SteveT10/MX104-HS/media/repo/3dRenderBack.png

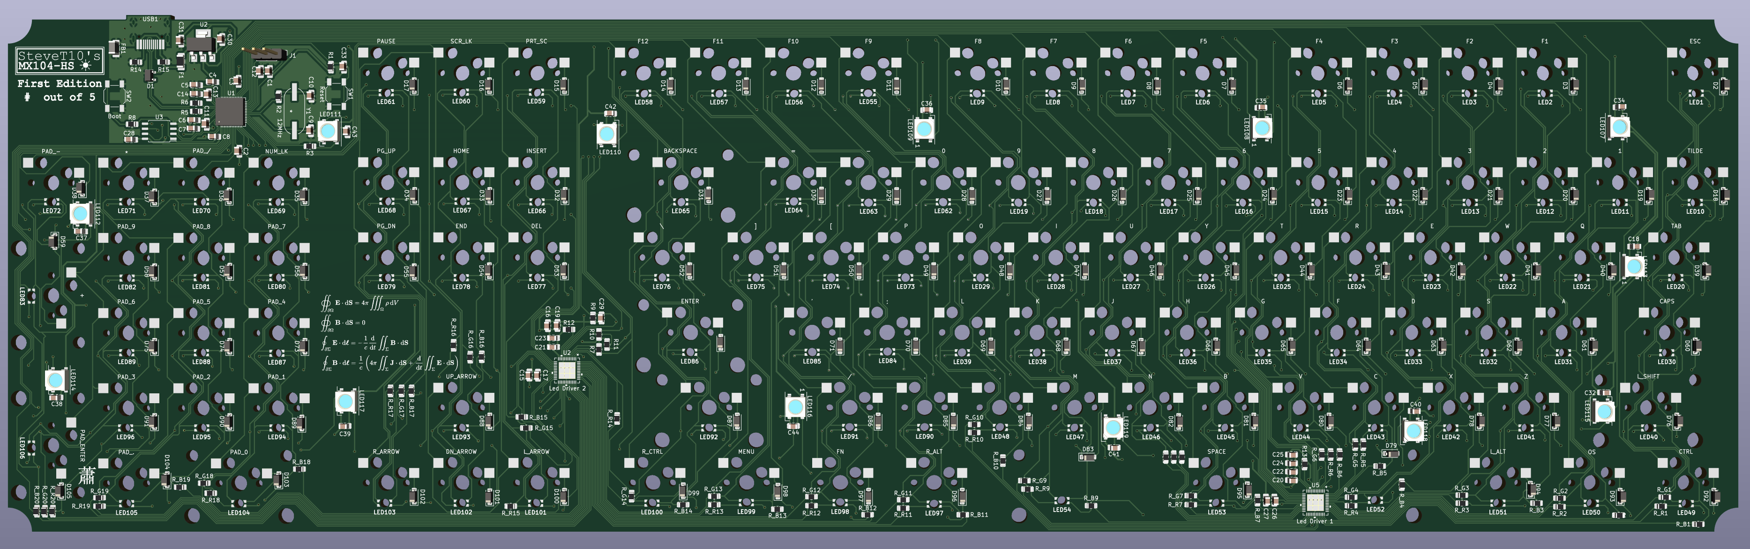
media/repo/3dRenderBack.png
