SteveT10/MX104-HS/media/repo/3dRenderFront.png

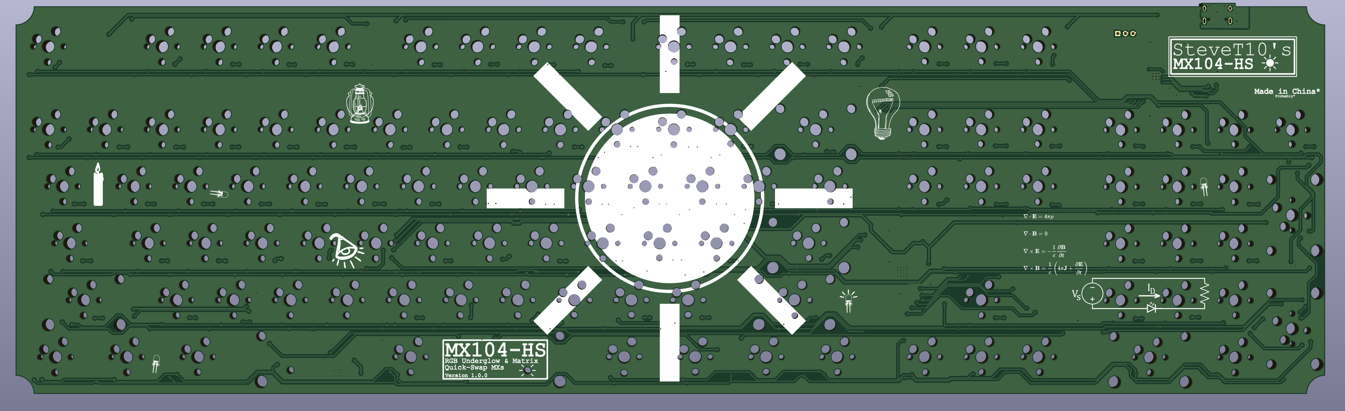
media/repo/3dRenderFront.png
