SteveT10/MX104-HS/media/repo/front_layout.png

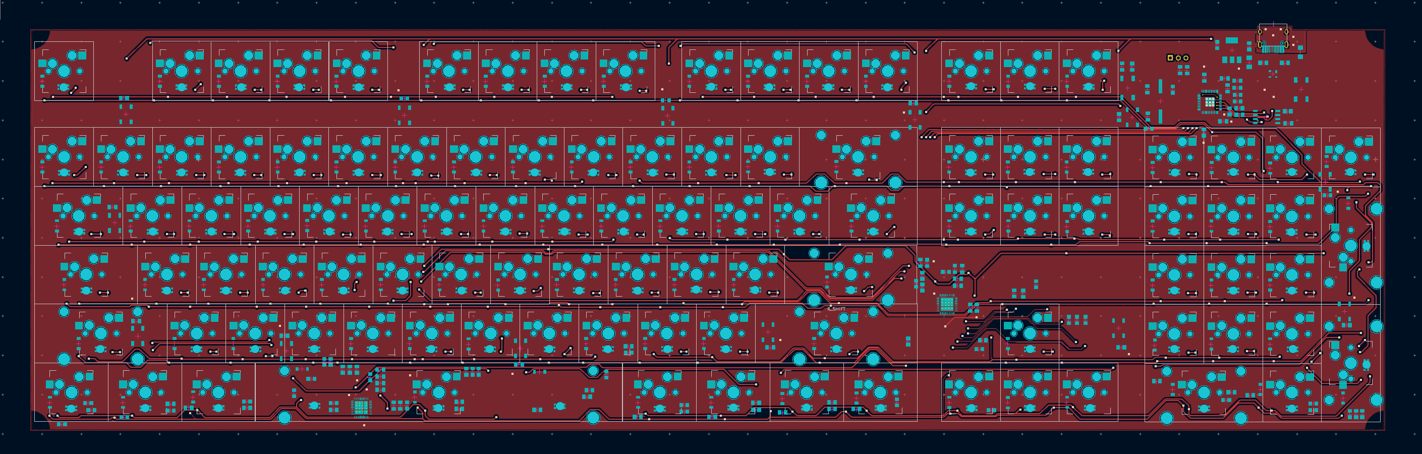
media/repo/front_layout.png
