SteveT10/MX104-HS/media/repo/front_PCB3.jpg

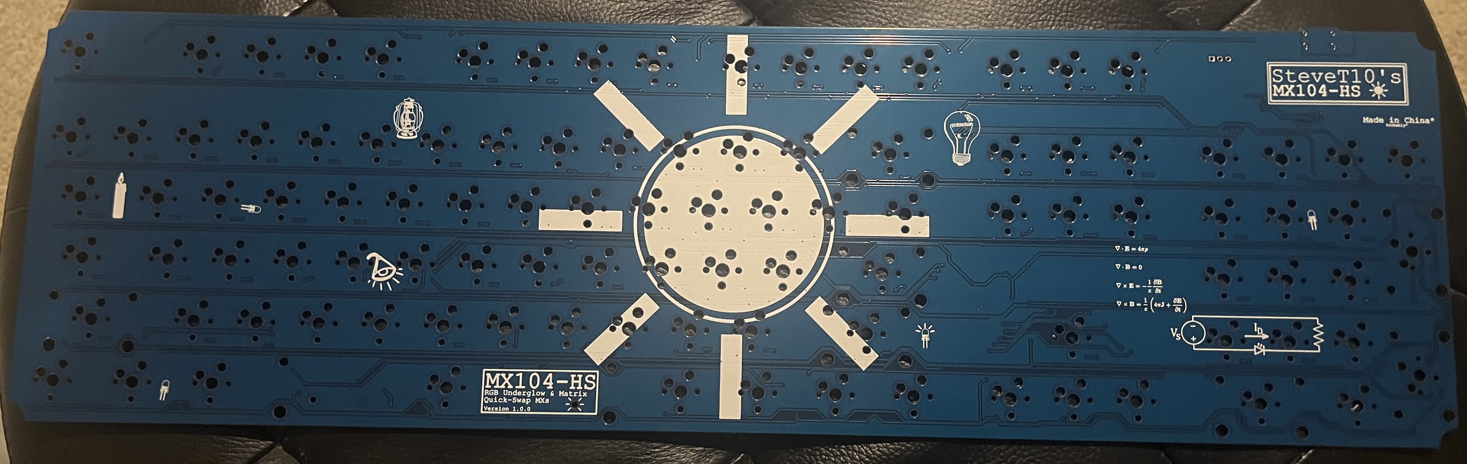
media/repo/front_PCB3.jpg
