SteveT10/MX104-HS/media/repo/full_layout.png

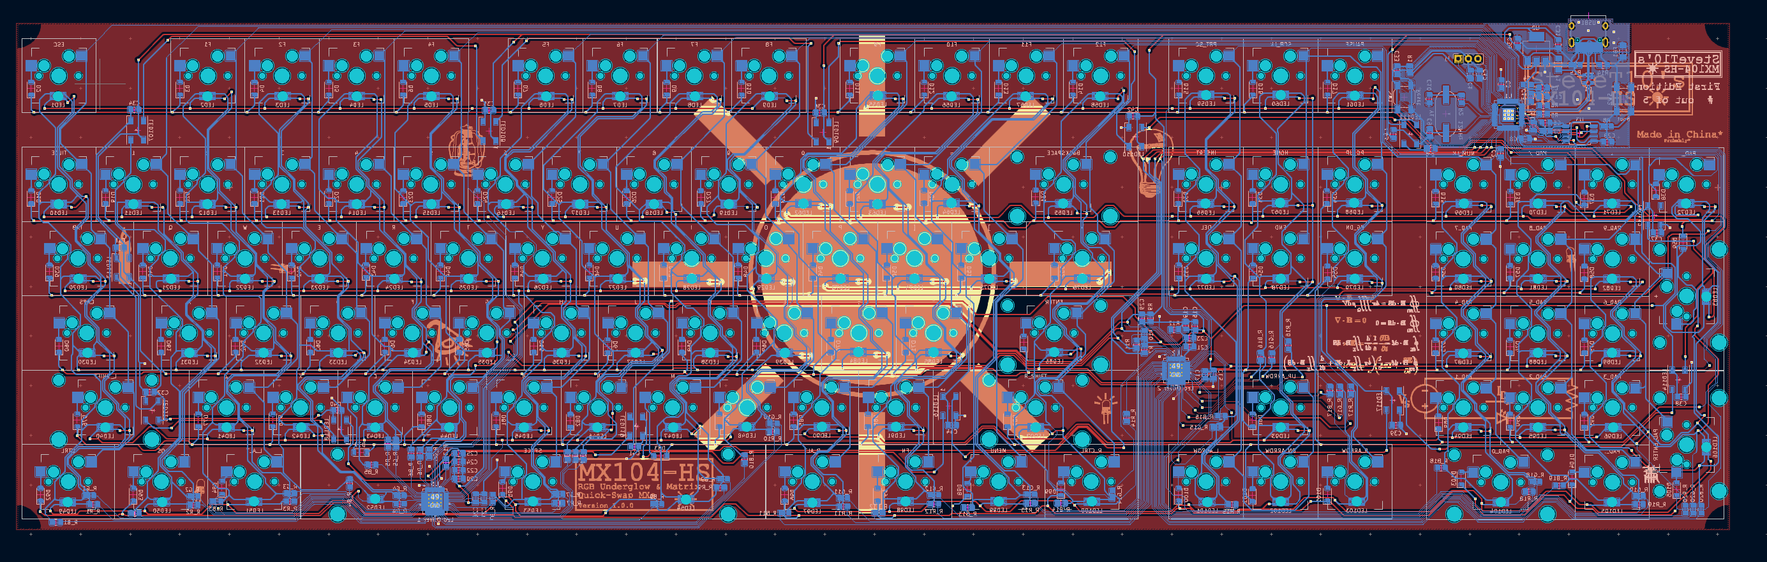
media/repo/full_layout.png
