SteveT10/MX104-HS/media/repo/KeyMatrices.png

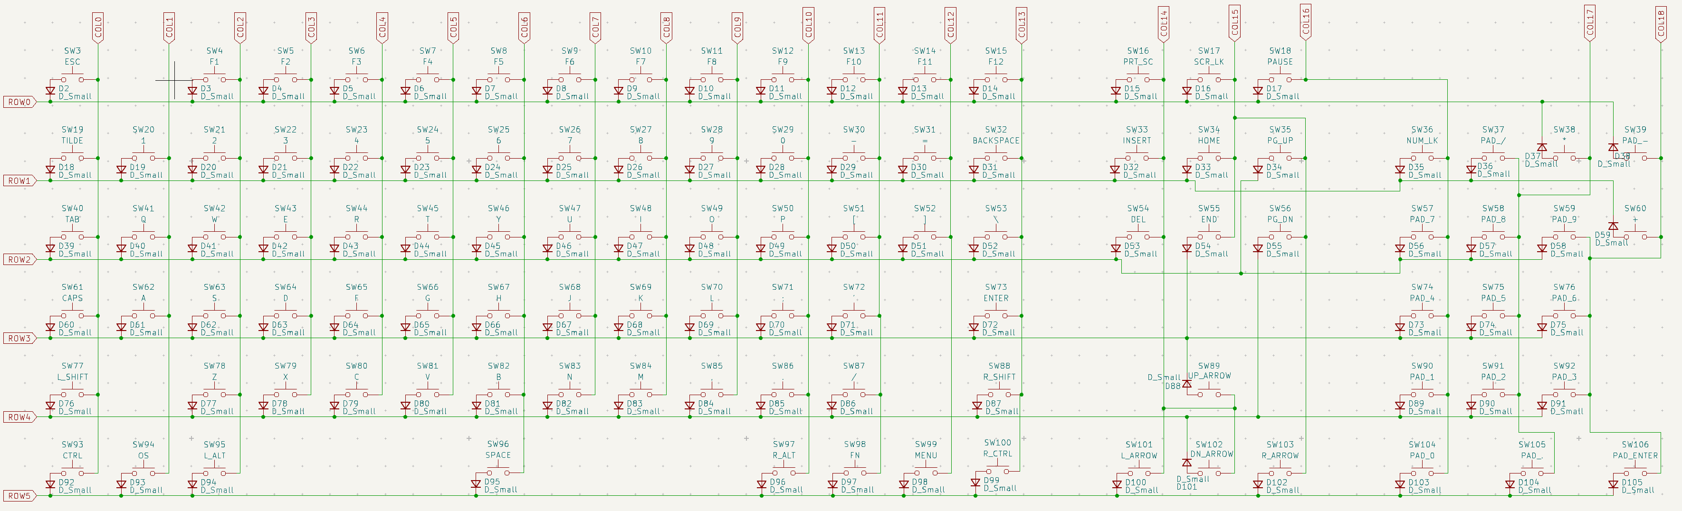
media/repo/KeyMatrices.png
