SteveT10/MX104-HS/media/repo/LedDriver1_layout.png

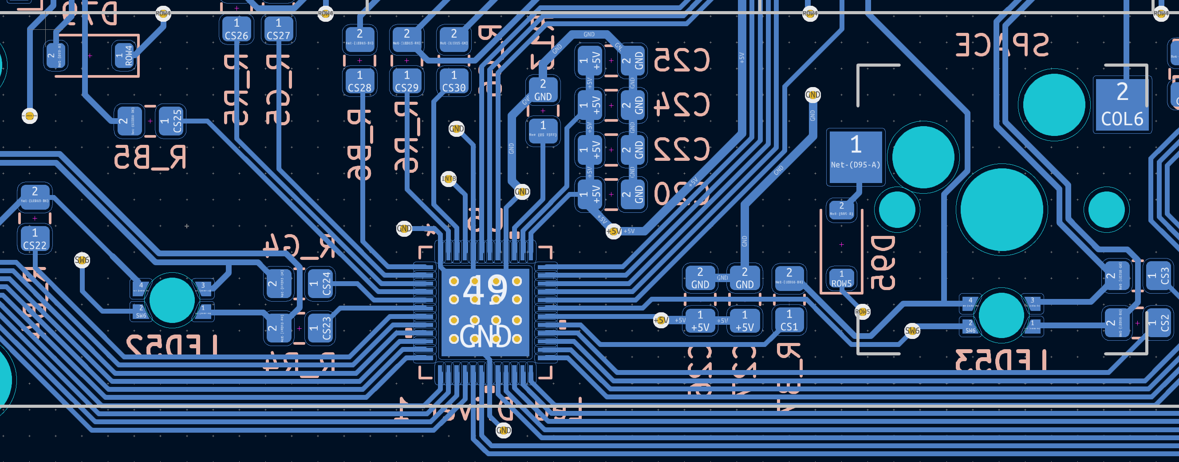
media/repo/LedDriver1_layout.png
