SteveT10/MX104-HS/media/repo/LedDriver2_layout.png

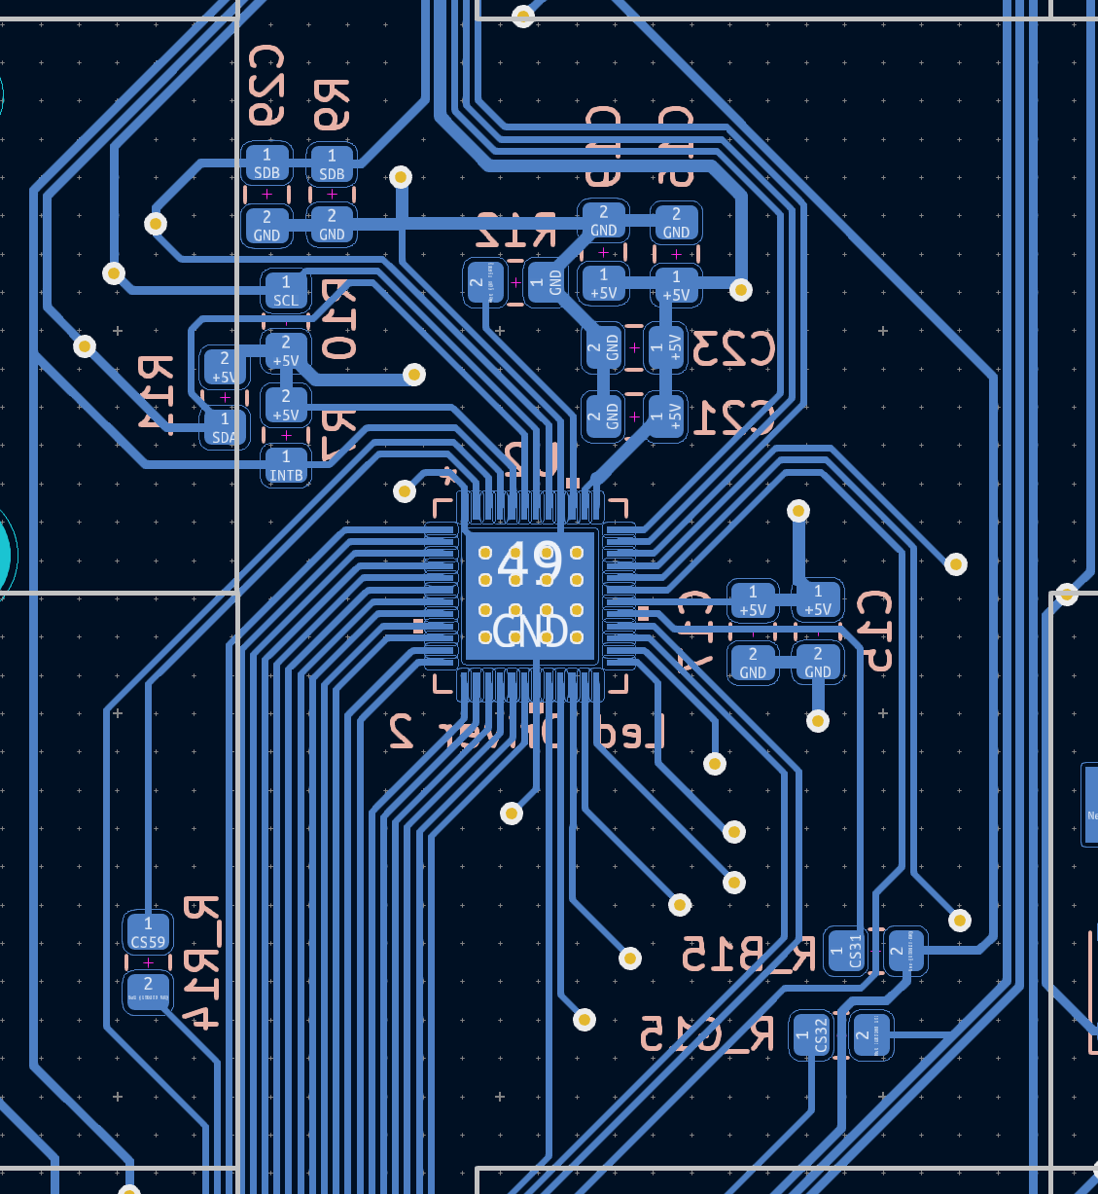
media/repo/LedDriver2_layout.png
