SteveT10/MX104-HS/media/repo/LEDS_sch.png

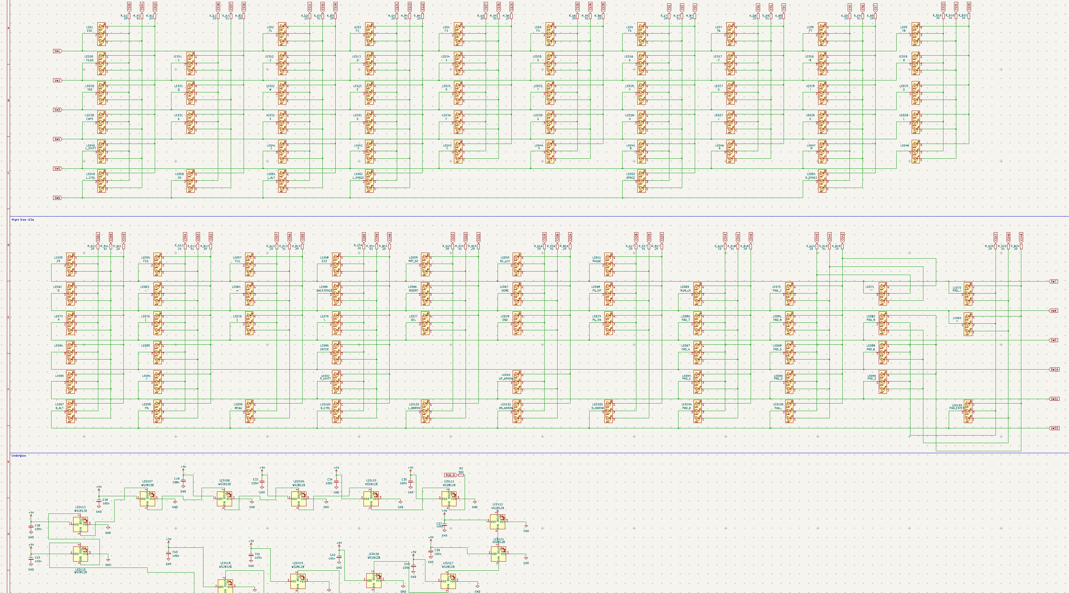
media/repo/LEDS_sch.png
