SteveT10/MX104-HS/media/repo/Main_sch.png

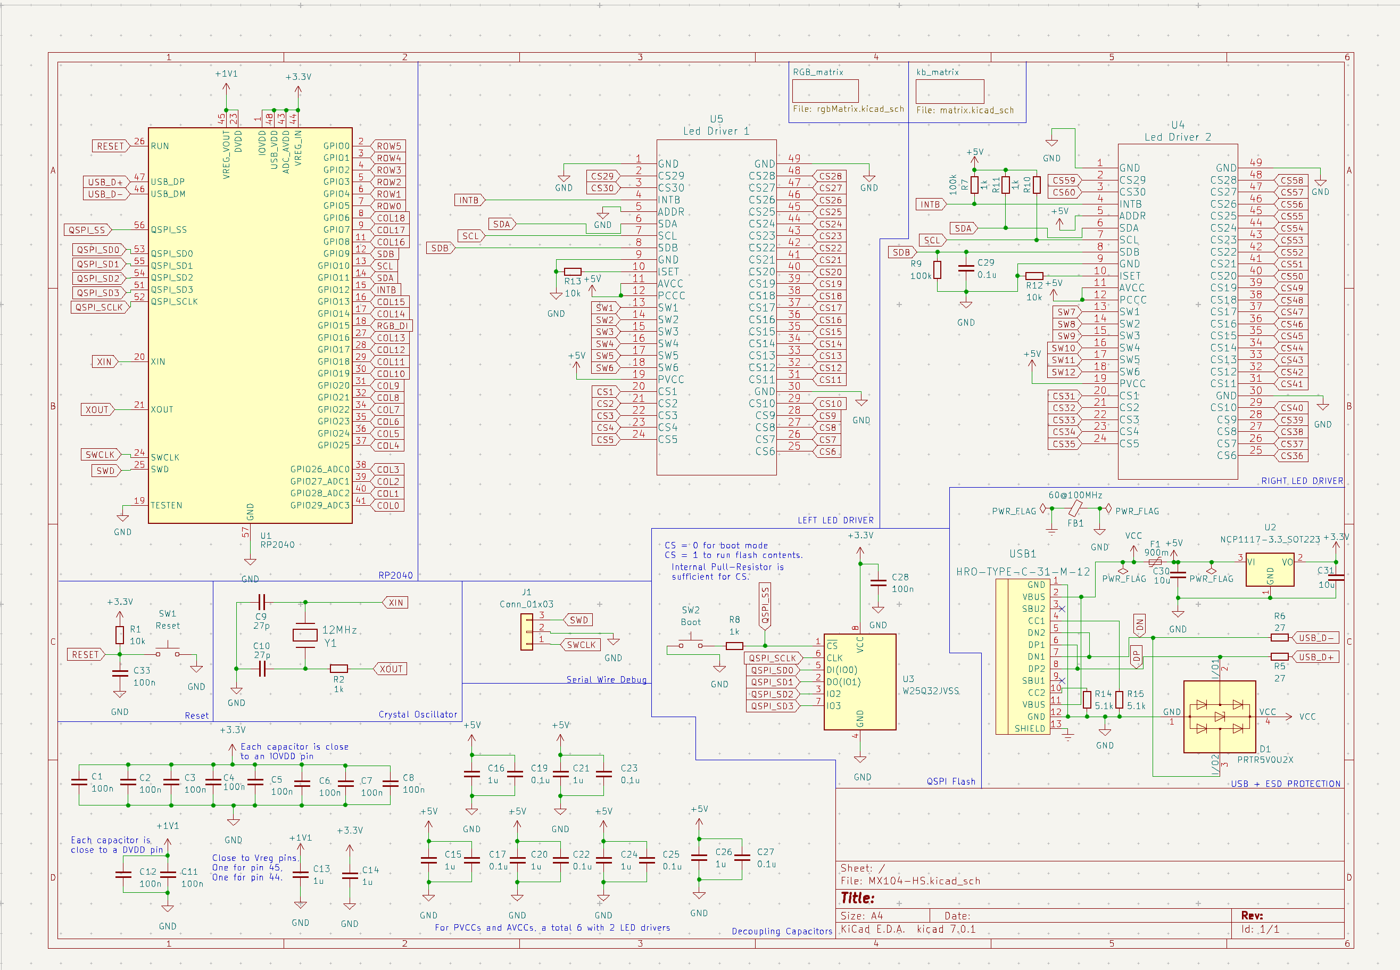
media/repo/Main_sch.png
