SteveT10/MX104-HS/media/repo/RP2040_layout.png

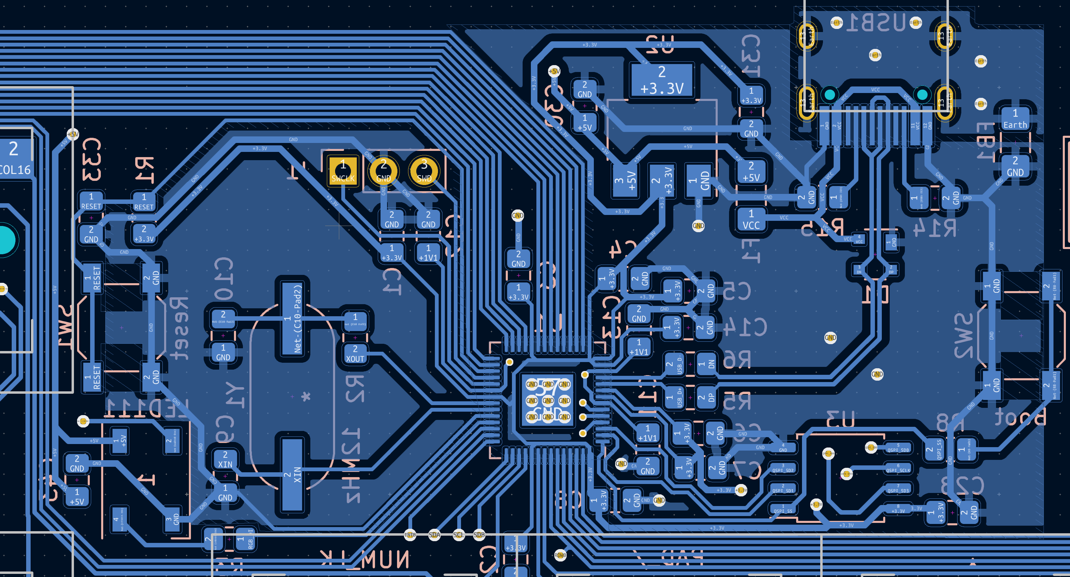
media/repo/RP2040_layout.png
