SteveT10/MX104-HS/MX104-HS.kicad_sch

## KiCad design MX104-HS.kicad_sch (2023-07-06)

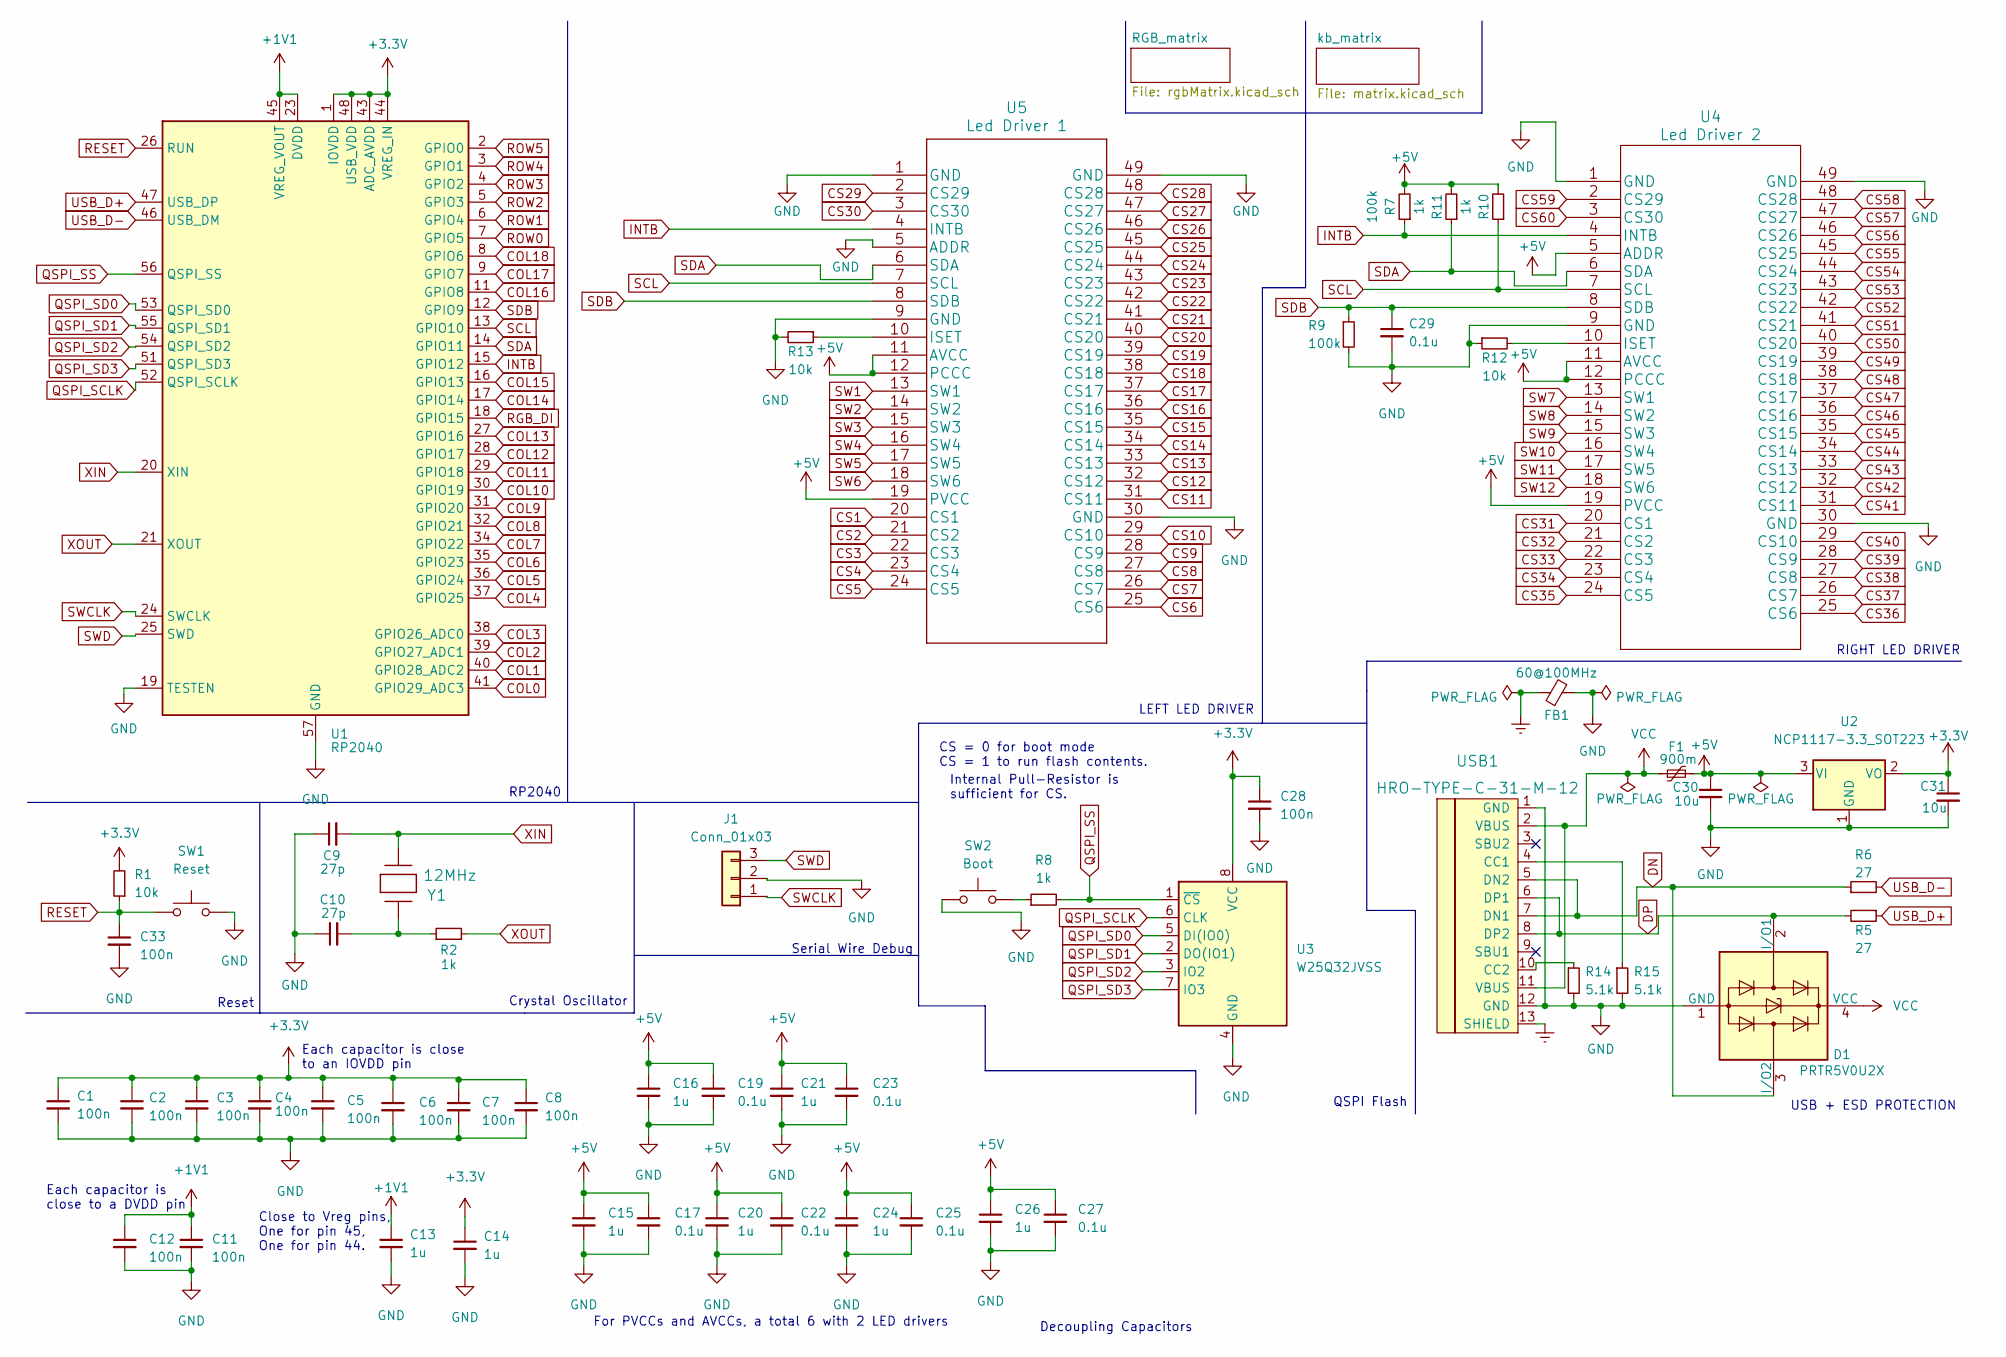
[picture p14: schematic MX104-HS.kicad_sch]

Parts:
C1, C2, C3, C4, C5, C6, C7, C8, C11, C12, C28, C33: 100n; C_0805_2012Metric_Pad1.18x1.45mm_HandSolder
C9, C10: 27p; C_0805_2012Metric_Pad1.18x1.45mm_HandSolder
C13, C14, C15, C16, C20, C21, C24, C26: 1u; C_0805_2012Metric_Pad1.18x1.45mm_HandSolder
C17, C19, C22, C23, C25, C27, C29: 0.1u; C_0805_2012Metric_Pad1.18x1.45mm_HandSolder
C30, C31: 10u; C_0805_2012Metric_Pad1.18x1.45mm_HandSolder
D1: PRTR5V0U2X; SOT-143
F1: 900m; Fuse_1206_3216Metric_Pad1.42x1.75mm_HandSolder
FB1: 60@100MHz; L_1206_3216Metric_Pad1.42x1.75mm_HandSolder
J1: Conn_01x03; PinHeader_1x03_P2.54mm_Vertical
R1, R12, R13: 10k; R_0805_2012Metric_Pad1.20x1.40mm_HandSolder
R2, R8, R10, R11: 1k; R_0805_2012Metric_Pad1.20x1.40mm_HandSolder
R5, R6: 27; R_0805_2012Metric_Pad1.20x1.40mm_HandSolder
R7, R9: 100k; R_0805_2012Metric_Pad1.20x1.40mm_HandSolder
R14, R15: 5.1k; R_0805_2012Metric_Pad1.20x1.40mm_HandSolder
SW1: Reset; SW_SPST_SKQG_WithStem
SW2: Boot; SW_SPST_SKQG_WithStem
U1: RP2040; QFN-56-1EP_7x7mm_P0.4mm_EP3.2x3.2mm
U2: NCP1117-3.3_SOT223; SOT-223-3_TabPin2
U3: W25Q32JVSS; SOIC-8_5.23x5.23mm_P1.27mm
U4: Led Driver 2; IS31FL3742A-QFLS4-TR
U5: Led Driver 1; IS31FL3742A-QFLS4-TR
USB1: HRO-TYPE-C-31-M-12; HRO-TYPE-C-31-M-12-HandSoldering
Y1: 12MHz; ABLS-12.000MHZ-B4-T

Connections:
+1V1: C11.1, C12.1, C13.1, U1.23 (DVDD), U1.45 (VREG_VOUT), U1.50 (DVDD)
+3.3V: C1.1, C2.1, C3.1, C4.1, C5.1, C6.1, C7.1, C8.1, C14.1, C28.1, C31.1, R1.2, U1.1 (IOVDD), U1.10 (IOVDD), U1.22 (IOVDD), U1.33 (IOVDD), U1.42 (IOVDD), U1.43 (ADC_AVDD), U1.44 (VREG_IN), U1.48 (USB_VDD), U1.49 (IOVDD), U2.2 (VO), U3.8 (VCC)
+5V: C15.1, C16.1, C17.1, C19.1, C20.1, C21.1, C22.1, C23.1, C24.1, C25.1, C26.1, C27.1, C30.1, F1.2, R7.2, R10.2, R11.2, U2.3 (VI), U4.5 (ADDR), U4.11 (AVCC), U4.12 (PCCC), U4.19 (PVCC), U5.11 (AVCC), U5.12 (PCCC), U5.19 (PVCC)
COL0: U1.41 (GPIO29_ADC3)
COL1: U1.40 (GPIO28_ADC2)
COL2: U1.39 (GPIO27_ADC1)
COL3: U1.38 (GPIO26_ADC0)
COL4: U1.37 (GPIO25)
COL5: U1.36 (GPIO24)
COL6: U1.35 (GPIO23)
COL7: U1.34 (GPIO22)
COL8: U1.32 (GPIO21)
COL9: U1.31 (GPIO20)
COL10: U1.30 (GPIO19)
COL11: U1.29 (GPIO18)
COL12: U1.28 (GPIO17)
COL13: U1.27 (GPIO16)
COL14: U1.17 (GPIO14)
COL15: U1.16 (GPIO13)
COL16: U1.11 (GPIO8)
COL17: U1.9 (GPIO7)
COL18: U1.8 (GPIO6)
CS1: U5.20 (CS1)
CS2: U5.21 (CS2)
CS3: U5.22 (CS3)
CS4: U5.23 (CS4)
CS5: U5.24 (CS5)
CS6: U5.25 (CS6)
CS7: U5.26 (CS7)
CS8: U5.27 (CS8)
CS9: U5.28 (CS9)
CS10: U5.29 (CS10)
CS11: U5.31 (CS11)
CS12: U5.32 (CS12)
CS13: U5.33 (CS13)
CS14: U5.34 (CS14)
CS15: U5.35 (CS15)
CS16: U5.36 (CS16)
CS17: U5.37 (CS17)
CS18: U5.38 (CS18)
CS19: U5.39 (CS19)
CS20: U5.40 (CS20)
CS21: U5.41 (CS21)
CS22: U5.42 (CS22)
CS23: U5.43 (CS23)
CS24: U5.44 (CS24)
CS25: U5.45 (CS25)
CS26: U5.46 (CS26)
CS27: U5.47 (CS27)
CS28: U5.48 (CS28)
CS29: U5.2 (CS29)
CS30: U5.3 (CS30)
CS31: U4.20 (CS1)
CS32: U4.21 (CS2)
CS33: U4.22 (CS3)
CS34: U4.23 (CS4)
CS35: U4.24 (CS5)
CS36: U4.25 (CS6)
CS37: U4.26 (CS7)
CS38: U4.27 (CS8)
CS39: U4.28 (CS9)
CS40: U4.29 (CS10)
CS41: U4.31 (CS11)
CS42: U4.32 (CS12)
CS43: U4.33 (CS13)
CS44: U4.34 (CS14)
CS45: U4.35 (CS15)
CS46: U4.36 (CS16)
CS47: U4.37 (CS17)
CS48: U4.38 (CS18)
CS49: U4.39 (CS19)
CS50: U4.40 (CS20)
CS51: U4.41 (CS21)
CS52: U4.42 (CS22)
CS53: U4.43 (CS23)
CS54: U4.44 (CS24)
CS55: U4.45 (CS25)
CS56: U4.46 (CS26)
CS57: U4.47 (CS27)
CS58: U4.48 (CS28)
CS59: U4.2 (CS29)
CS60: U4.3 (CS30)
DN: D1.3 (I/O2), R6.1, USB1.5 (DN2), USB1.7 (DN1)
DP: D1.2 (I/O1), R5.2, USB1.6 (DP1), USB1.8 (DP2)
Earth: FB1.1, USB1.13 (SHIELD)
GND: C1.2, C2.2, C3.2, C4.2, C5.2, C6.2, C7.2, C8.2, C9.1, C10.1, C11.2, C12.2, C13.2, C14.2, C15.2, C16.2, C17.2, C19.2, C20.2, C21.2, C22.2, C23.2, C24.2, C25.2, C26.2, C27.2, C28.2, C29.2, C30.2, C31.2, C33.2, D1.1 (GND), FB1.2, J1.2, R9.2, R12.1, R13.2, R14.2, R15.2, SW1.2, SW2.1, U1.19 (TESTEN), U1.57 (GND), U2.1 (GND), U3.4 (GND), U4.1 (GND), U4.9 (GND), U4.30 (GND), U4.49 (GND), U5.1 (GND), U5.5 (ADDR), U5.9 (GND), U5.30 (GND), U5.49 (GND), USB1.1 (GND), USB1.12 (GND)
INTB: R7.1, U1.15 (GPIO12), U4.4 (INTB), U5.4 (INTB)
unnamed: C10.2, R2.1, Y1.1
unnamed: R8.1, SW2.2
unnamed: R12.2, U4.10 (ISET)
unnamed: R13.1, U5.10 (ISET)
unnamed: R14.1, USB1.10 (CC2)
unnamed: R15.1, USB1.4 (CC1)
QSPI_SCLK: U1.52 (QSPI_SCLK), U3.6 (CLK)
QSPI_SD0: U1.53 (QSPI_SD0), U3.5 (DI(IO0))
QSPI_SD1: U1.55 (QSPI_SD1), U3.2 (DO(IO1))
QSPI_SD2: U1.54 (QSPI_SD2), U3.3 (IO2)
QSPI_SD3: U1.51 (QSPI_SD3), U3.7 (IO3)
QSPI_SS: R8.2, U1.56 (QSPI_SS), U3.1 (~CS)
RESET: C33.1, R1.1, SW1.1, U1.26 (RUN)
RGB_DI: U1.18 (GPIO15)
ROW0: U1.7 (GPIO5)
ROW1: U1.6 (GPIO4)
ROW2: U1.5 (GPIO3)
ROW3: U1.4 (GPIO2)
ROW4: U1.3 (GPIO1)
ROW5: U1.2 (GPIO0)
SCL: R10.1, U1.13 (GPIO10), U4.7 (SCL), U5.7 (SCL)
SDA: R11.1, U1.14 (GPIO11), U4.6 (SDA), U5.6 (SDA)
SDB: C29.1, R9.1, U1.12 (GPIO9), U4.8 (SDB), U5.8 (SDB)
SW1: U5.13 (SW1)
SW2: U5.14 (SW2)
SW3: U5.15 (SW3)
SW4: U5.16 (SW4)
SW5: U5.17 (SW5)
SW6: U5.18 (SW6)
SW7: U4.13 (SW1)
SW8: U4.14 (SW2)
SW9: U4.15 (SW3)
SW10: U4.16 (SW4)
SW11: U4.17 (SW5)
SW12: U4.18 (SW6)
SWCLK: J1.1, U1.24 (SWCLK)
SWD: J1.3, U1.25 (SWD)
USB_D+: R5.1, U1.47 (USB_DP)
USB_D-: R6.2, U1.46 (USB_DM)
VCC: D1.4 (VCC), F1.1, USB1.2 (VBUS), USB1.11 (VBUS)
XIN: C9.2, U1.20 (XIN), Y1.2
XOUT: R2.2, U1.21 (XOUT)

Notes on the sheet:
LEFT LED DRIVER
Close to Vreg pins, One for pin 45, One for pin 44.
RP2040
RIGHT LED DRIVER
Internal Pull-Resistor is sufficient for CS.
Decoupling Capacitors
Serial Wire Debug
Each capacitor is close to an IOVDD pin
Crystal Oscillator
CS = 0 for boot mode CS = 1 to run flash contents.
Reset
USB + ESD PROTECTION
Each capacitor is close to a DVDD pin
QSPI Flash
For PVCCs and AVCCs, a total 6 with 2 LED drivers
