SteveT10/MX104-HS/rgbMatrix.kicad_sch

## KiCad design rgbMatrix.kicad_sch (2023-07-02)

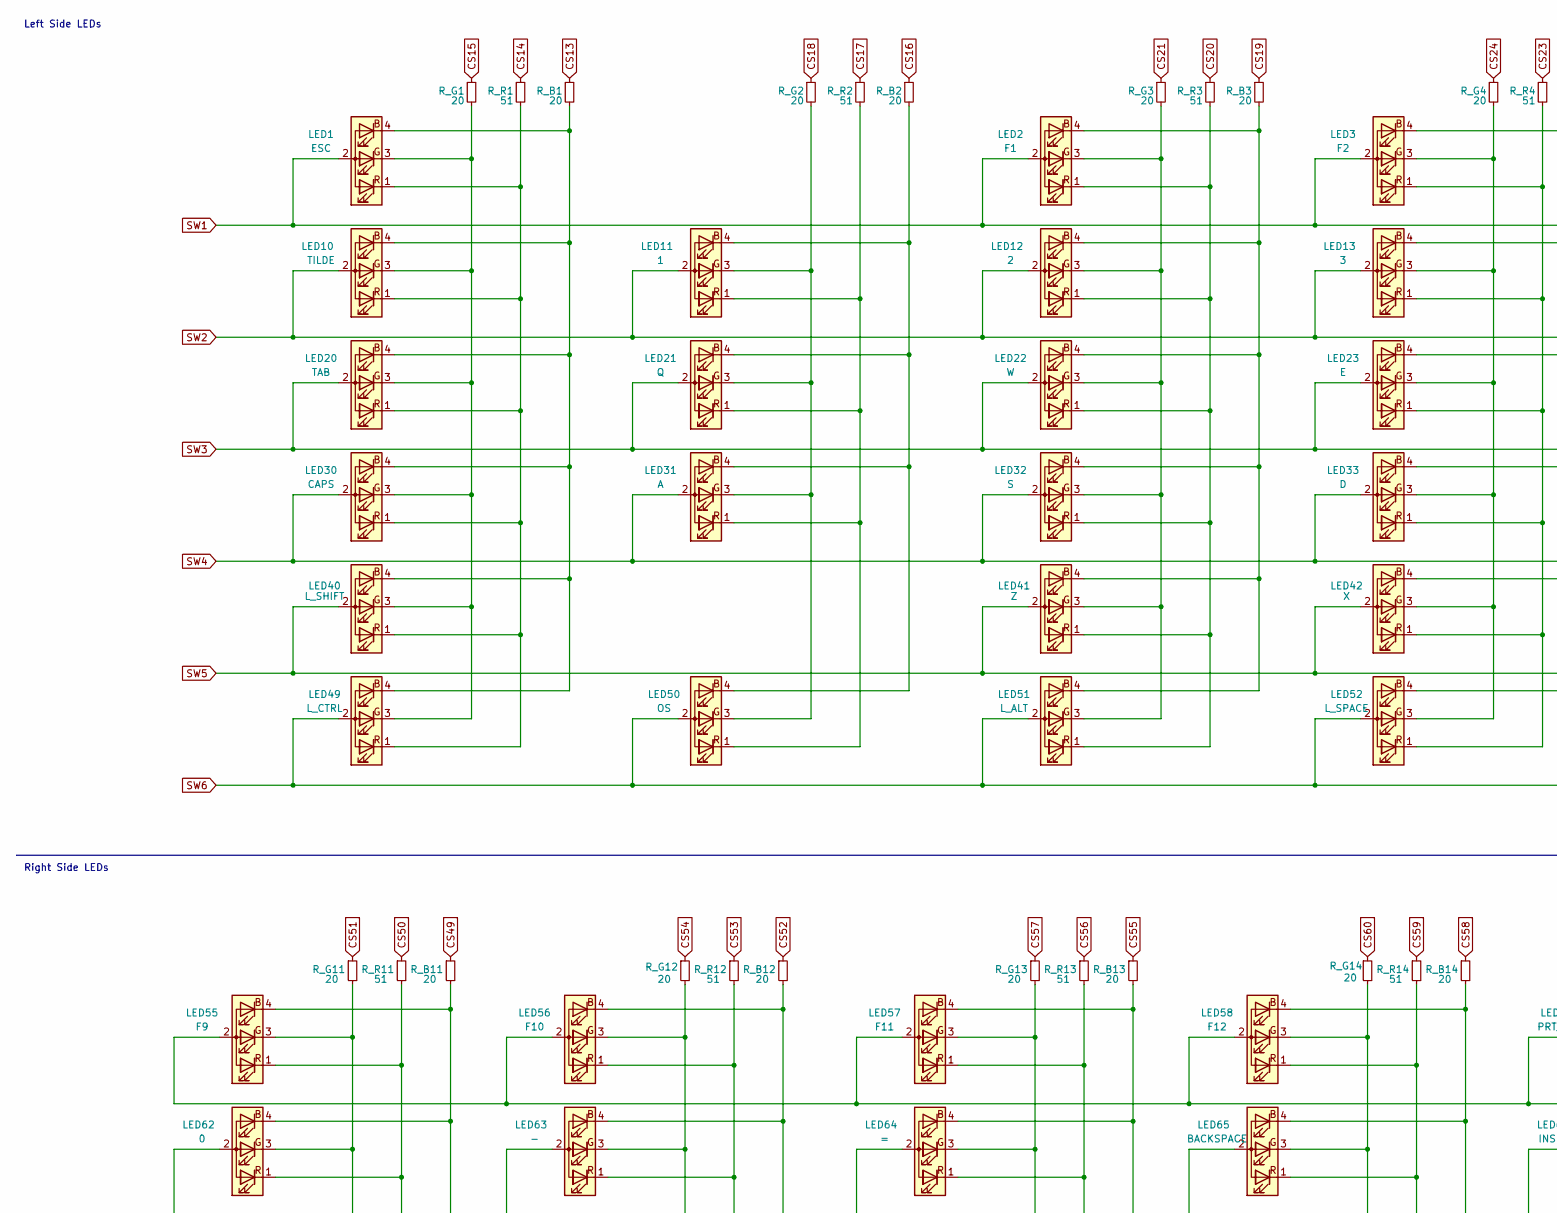
[picture p16: schematic rgbMatrix.kicad_sch, part in row 1, column 1]

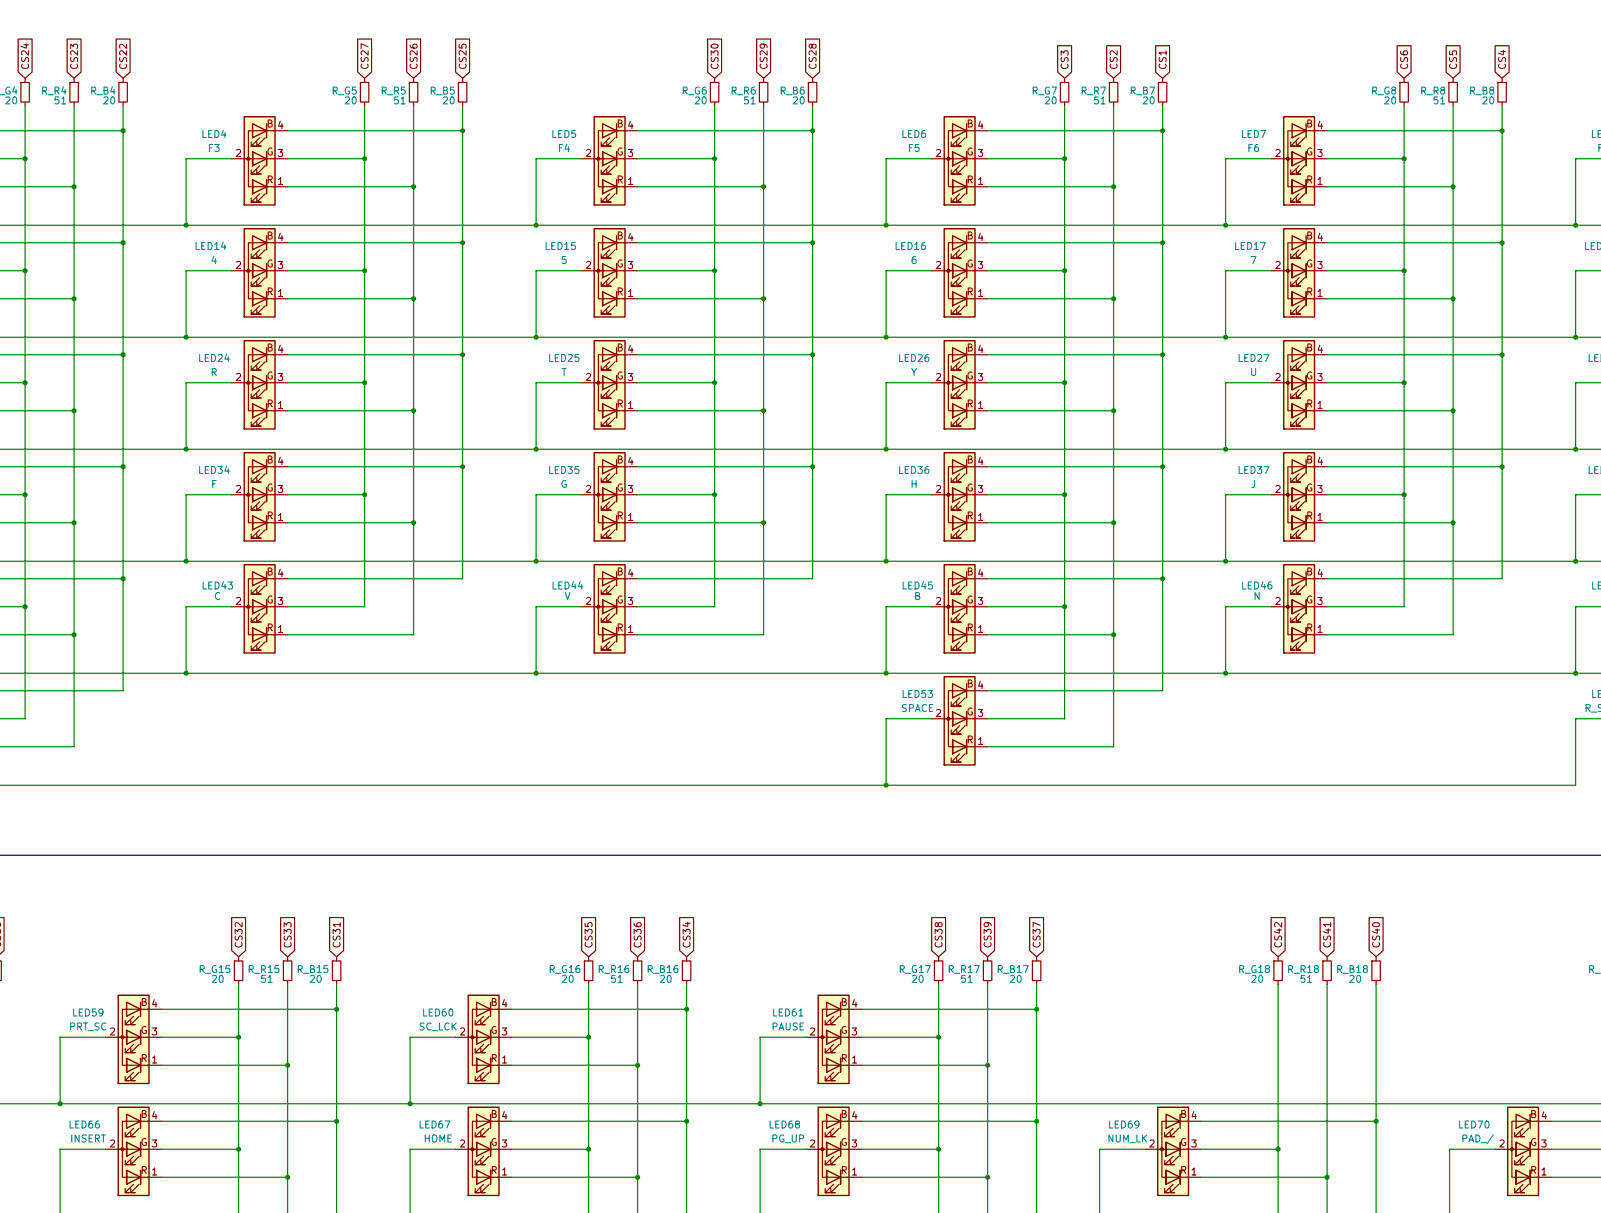
[picture p17: schematic rgbMatrix.kicad_sch, part in row 1, column 2]

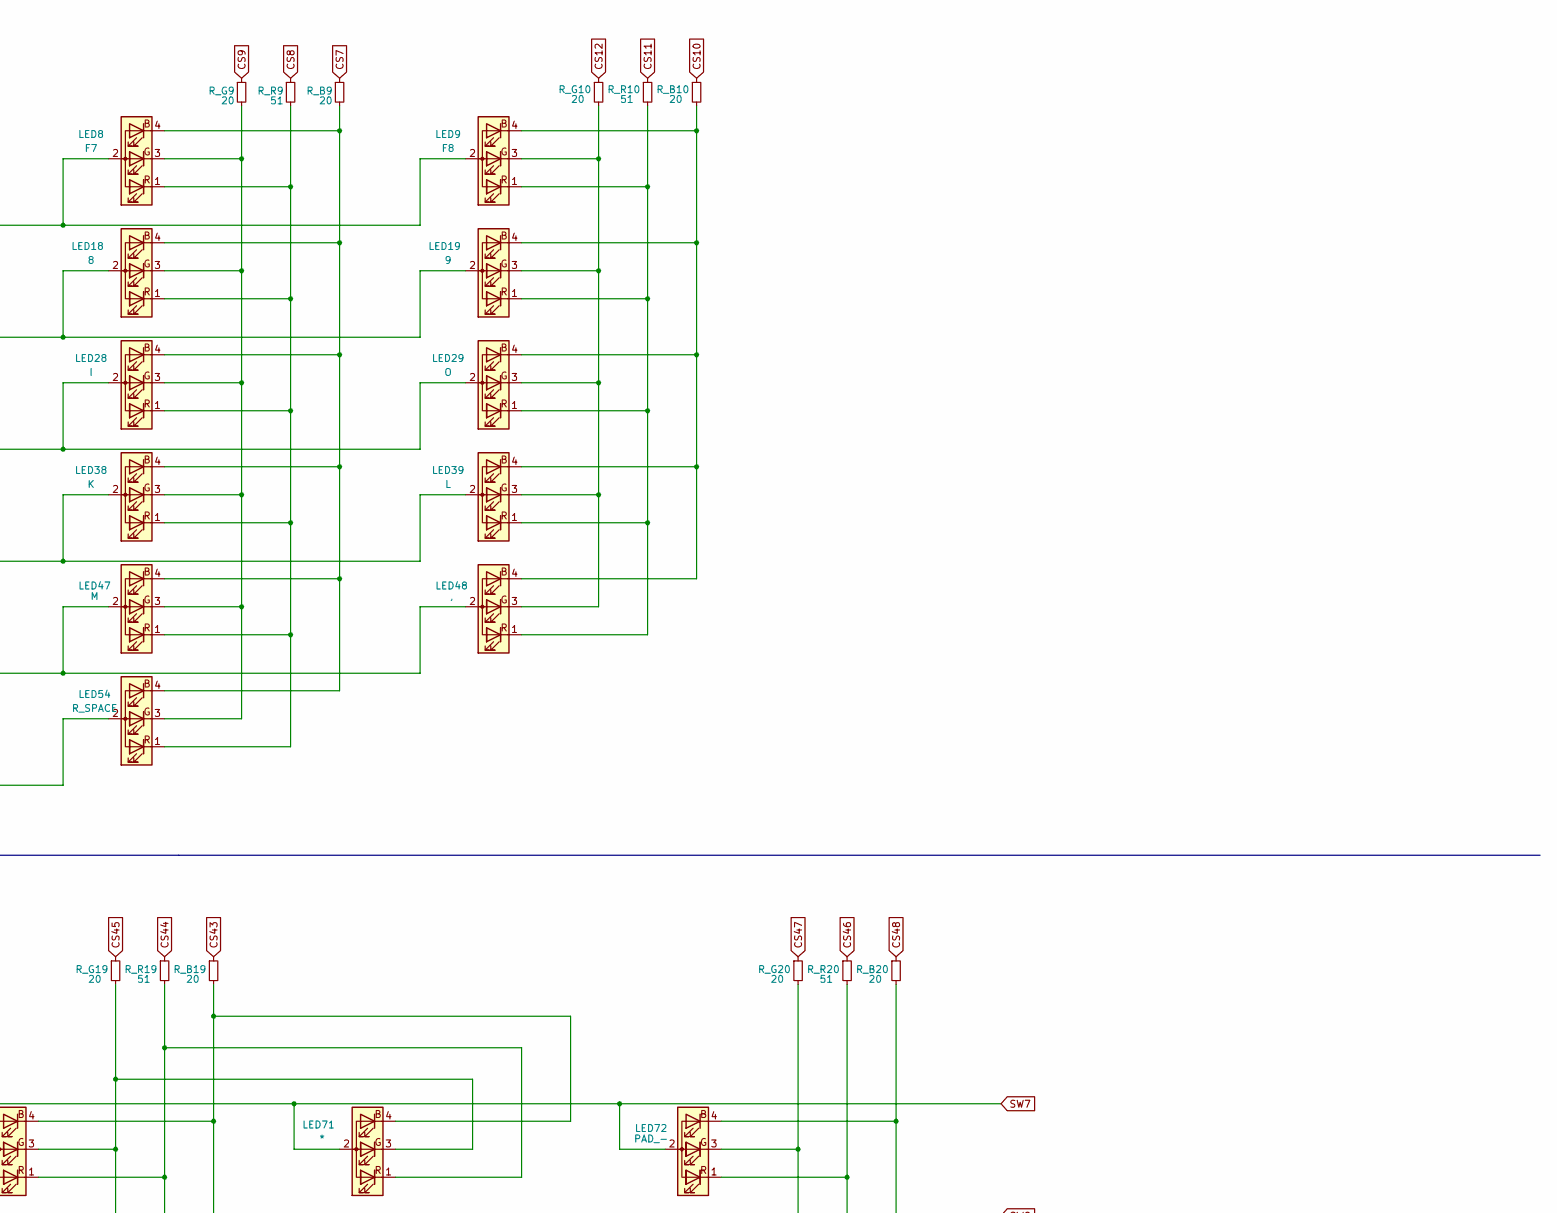
[picture p18: schematic rgbMatrix.kicad_sch, part in row 1, column 3]

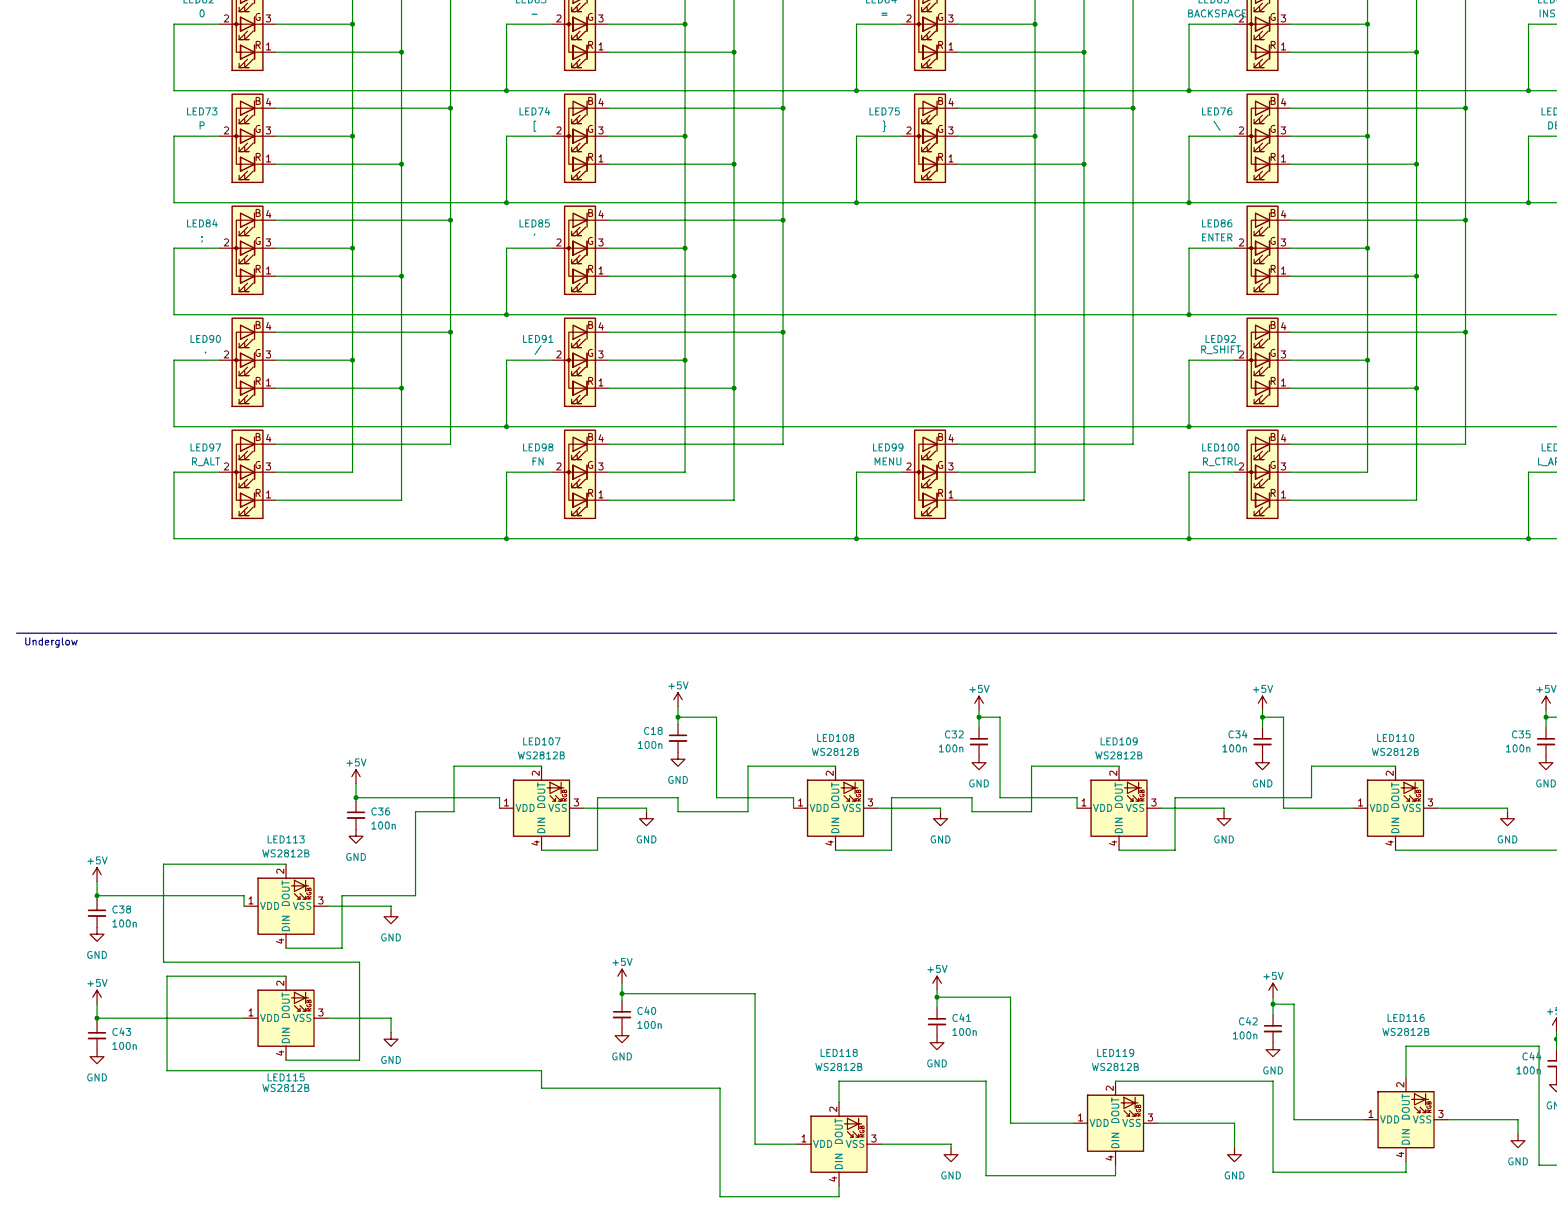
[picture p19: schematic rgbMatrix.kicad_sch, part in row 2, column 1]

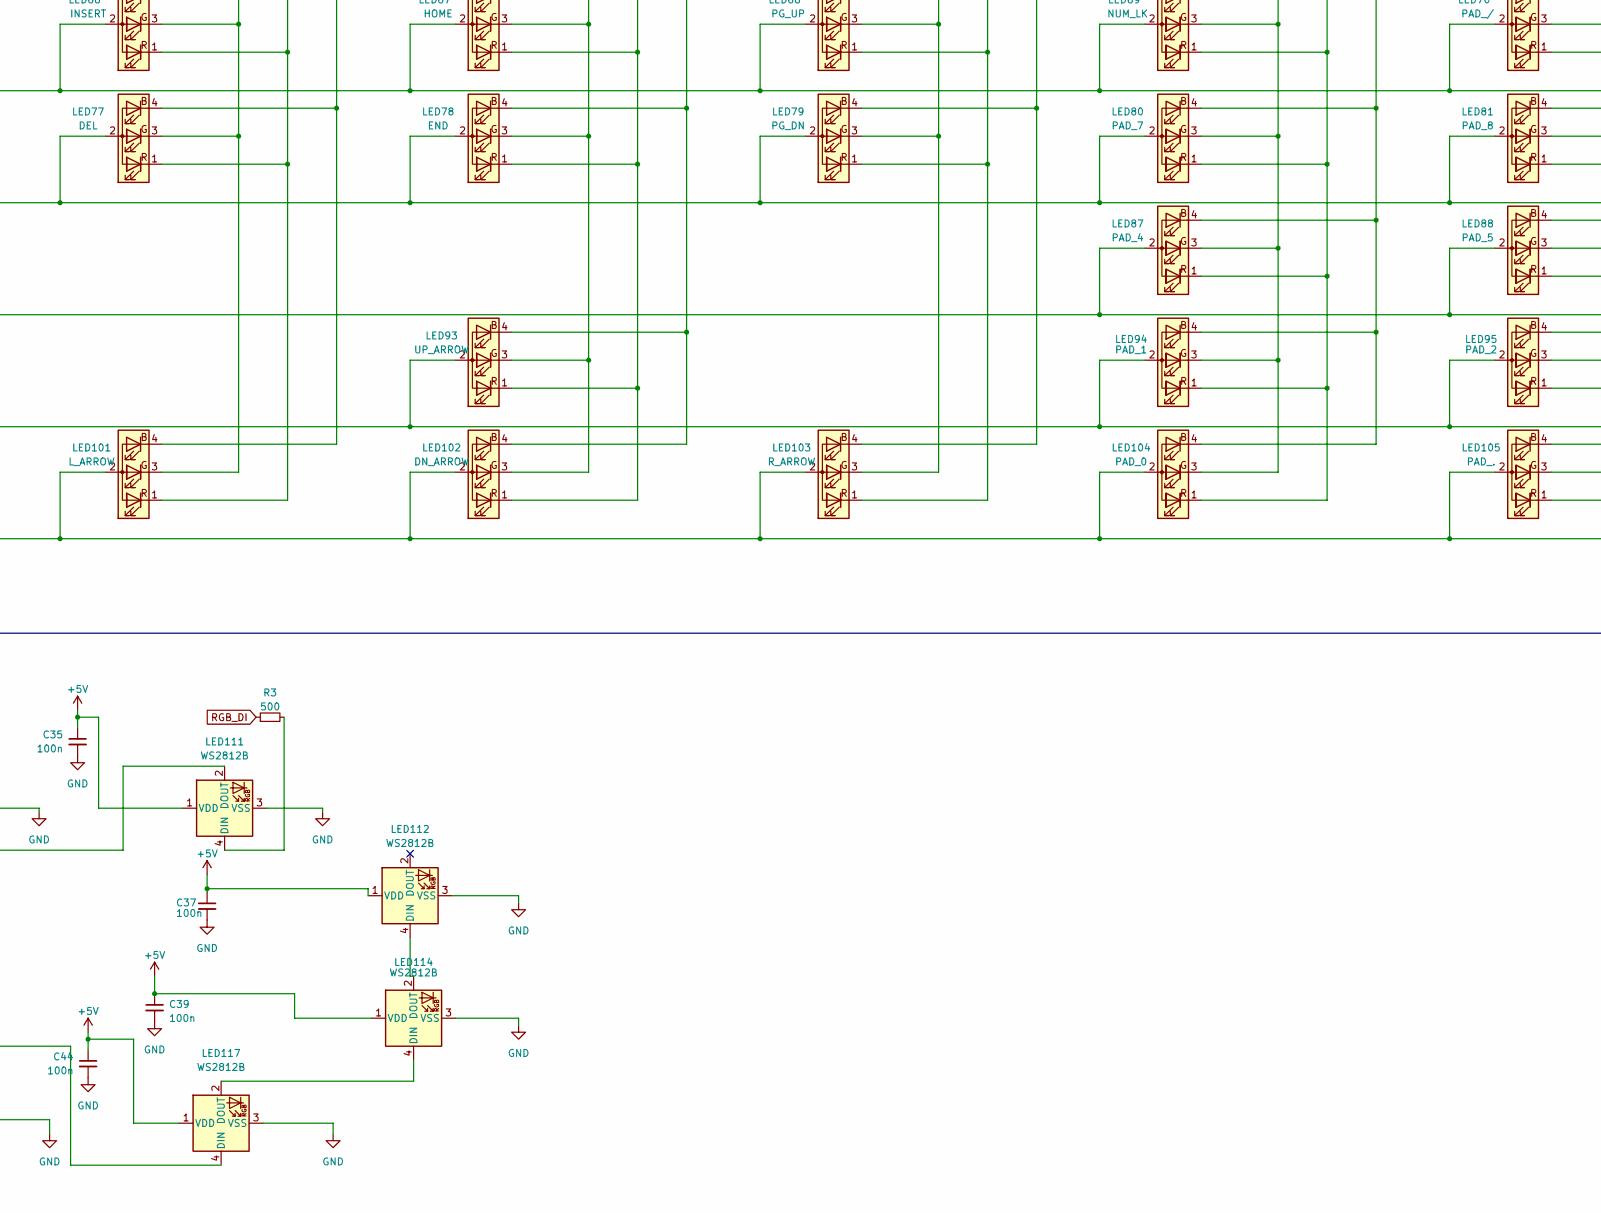
[picture p20: schematic rgbMatrix.kicad_sch, part in row 2, column 2]

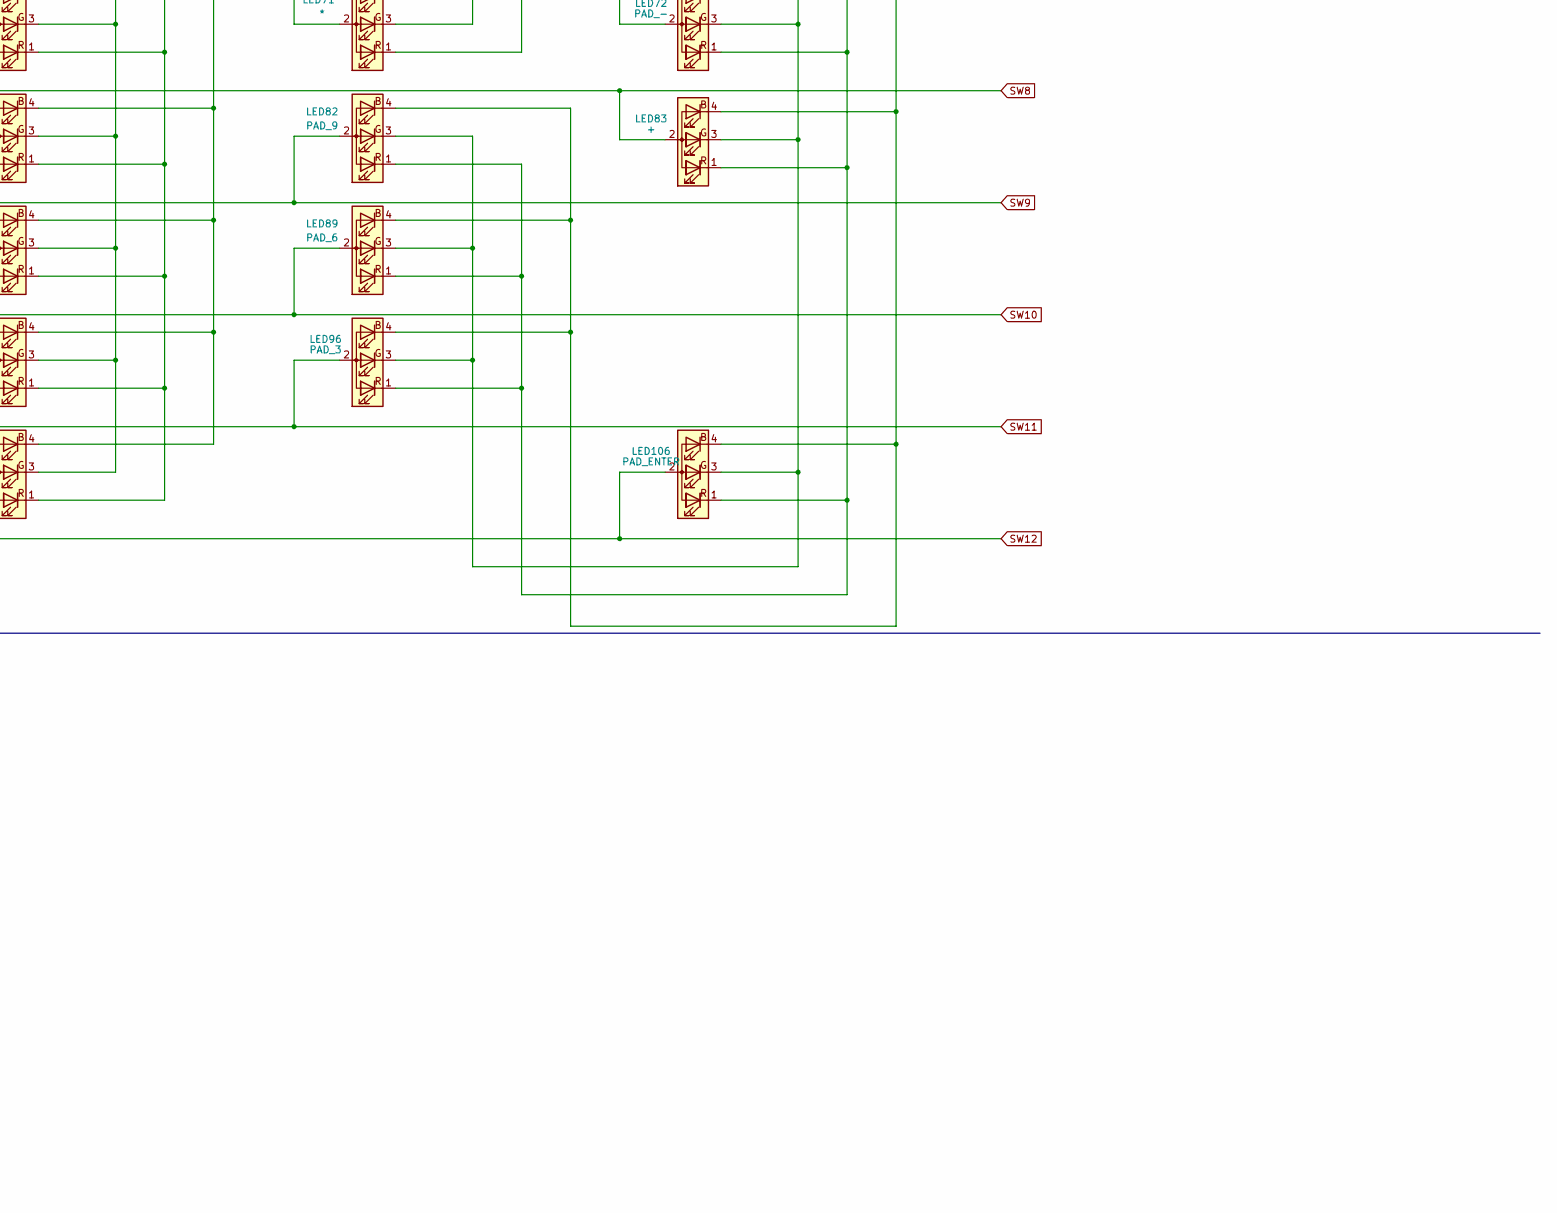
[picture p21: schematic rgbMatrix.kicad_sch, part in row 2, column 3]

Parts:
C18, C32, C34, C35, C36, C37, C38, C39, C40, C41, C42, C43, C44: 100n; C_0805_2012Metric_Pad1.18x1.45mm_HandSolder
LED1: ESC; LED__RBG_1206_3216Metric_ReverseMount_Hole2.2x2.2mm
LED2: F1; LED__RBG_1206_3216Metric_ReverseMount_Hole2.2x2.2mm
LED3: F2; LED__RBG_1206_3216Metric_ReverseMount_Hole2.2x2.2mm
LED4: F3; LED__RBG_1206_3216Metric_ReverseMount_Hole2.2x2.2mm
LED5: F4; LED__RBG_1206_3216Metric_ReverseMount_Hole2.2x2.2mm
LED6: F5; LED__RBG_1206_3216Metric_ReverseMount_Hole2.2x2.2mm
LED7: F6; LED__RBG_1206_3216Metric_ReverseMount_Hole2.2x2.2mm
LED8: F7; LED__RBG_1206_3216Metric_ReverseMount_Hole2.2x2.2mm
LED9: F8; LED__RBG_1206_3216Metric_ReverseMount_Hole2.2x2.2mm
LED10: TILDE; LED__RBG_1206_3216Metric_ReverseMount_Hole2.2x2.2mm
LED11: 1; LED__RBG_1206_3216Metric_ReverseMount_Hole2.2x2.2mm
LED12: 2; LED__RBG_1206_3216Metric_ReverseMount_Hole2.2x2.2mm
LED13: 3; LED__RBG_1206_3216Metric_ReverseMount_Hole2.2x2.2mm
LED14: 4; LED__RBG_1206_3216Metric_ReverseMount_Hole2.2x2.2mm
LED15: 5; LED__RBG_1206_3216Metric_ReverseMount_Hole2.2x2.2mm
LED16: 6; LED__RBG_1206_3216Metric_ReverseMount_Hole2.2x2.2mm
LED17: 7; LED__RBG_1206_3216Metric_ReverseMount_Hole2.2x2.2mm
LED18: 8; LED__RBG_1206_3216Metric_ReverseMount_Hole2.2x2.2mm
LED19: 9; LED__RBG_1206_3216Metric_ReverseMount_Hole2.2x2.2mm
LED20: TAB; LED__RBG_1206_3216Metric_ReverseMount_Hole2.2x2.2mm
LED21: Q; LED__RBG_1206_3216Metric_ReverseMount_Hole2.2x2.2mm
LED22: W; LED__RBG_1206_3216Metric_ReverseMount_Hole2.2x2.2mm
LED23: E; LED__RBG_1206_3216Metric_ReverseMount_Hole2.2x2.2mm
LED24: R; LED__RBG_1206_3216Metric_ReverseMount_Hole2.2x2.2mm
LED25: T; LED__RBG_1206_3216Metric_ReverseMount_Hole2.2x2.2mm
LED26: Y; LED__RBG_1206_3216Metric_ReverseMount_Hole2.2x2.2mm
LED27: U; LED__RBG_1206_3216Metric_ReverseMount_Hole2.2x2.2mm
LED28: I; LED__RBG_1206_3216Metric_ReverseMount_Hole2.2x2.2mm
LED29: O; LED__RBG_1206_3216Metric_ReverseMount_Hole2.2x2.2mm
LED30: CAPS; LED__RBG_1206_3216Metric_ReverseMount_Hole2.2x2.2mm
LED31: A; LED__RBG_1206_3216Metric_ReverseMount_Hole2.2x2.2mm
LED32: S; LED__RBG_1206_3216Metric_ReverseMount_Hole2.2x2.2mm
LED33: D; LED__RBG_1206_3216Metric_ReverseMount_Hole2.2x2.2mm
LED34: F; LED__RBG_1206_3216Metric_ReverseMount_Hole2.2x2.2mm
LED35: G; LED__RBG_1206_3216Metric_ReverseMount_Hole2.2x2.2mm
LED36: H; LED__RBG_1206_3216Metric_ReverseMount_Hole2.2x2.2mm
LED37: J; LED__RBG_1206_3216Metric_ReverseMount_Hole2.2x2.2mm
LED38: K; LED__RBG_1206_3216Metric_ReverseMount_Hole2.2x2.2mm
LED39: L; LED__RBG_1206_3216Metric_ReverseMount_Hole2.2x2.2mm
LED40: L_SHIFT; LED__RBG_1206_3216Metric_ReverseMount_Hole2.2x2.2mm
LED41: Z; LED__RBG_1206_3216Metric_ReverseMount_Hole2.2x2.2mm
LED42: X; LED__RBG_1206_3216Metric_ReverseMount_Hole2.2x2.2mm
LED43: C; LED__RBG_1206_3216Metric_ReverseMount_Hole2.2x2.2mm
LED44: V; LED__RBG_1206_3216Metric_ReverseMount_Hole2.2x2.2mm
LED45: B; LED__RBG_1206_3216Metric_ReverseMount_Hole2.2x2.2mm
LED46: N; LED__RBG_1206_3216Metric_ReverseMount_Hole2.2x2.2mm
LED47: M; LED__RBG_1206_3216Metric_ReverseMount_Hole2.2x2.2mm
LED48: ,; LED__RBG_1206_3216Metric_ReverseMount_Hole2.2x2.2mm
LED49: L_CTRL; LED__RBG_1206_3216Metric_ReverseMount_Hole2.2x2.2mm
LED50: OS; LED__RBG_1206_3216Metric_ReverseMount_Hole2.2x2.2mm
LED51: L_ALT; LED__RBG_1206_3216Metric_ReverseMount_Hole2.2x2.2mm
LED52: L_SPACE; LED__RBG_1206_3216Metric_ReverseMount_Hole2.2x2.2mm
LED53: SPACE; LED__RBG_1206_3216Metric_ReverseMount_Hole2.2x2.2mm
LED54: R_SPACE; LED__RBG_1206_3216Metric_ReverseMount_Hole2.2x2.2mm
LED55: F9; LED__RBG_1206_3216Metric_ReverseMount_Hole2.2x2.2mm
LED56: F10; LED__RBG_1206_3216Metric_ReverseMount_Hole2.2x2.2mm
LED57: F11; LED__RBG_1206_3216Metric_ReverseMount_Hole2.2x2.2mm
LED58: F12; LED__RBG_1206_3216Metric_ReverseMount_Hole2.2x2.2mm
LED59: PRT_SC; LED__RBG_1206_3216Metric_ReverseMount_Hole2.2x2.2mm
LED60: SC_LCK; LED__RBG_1206_3216Metric_ReverseMount_Hole2.2x2.2mm
LED61: PAUSE; LED__RBG_1206_3216Metric_ReverseMount_Hole2.2x2.2mm
LED62: 0; LED__RBG_1206_3216Metric_ReverseMount_Hole2.2x2.2mm
LED63: -; LED__RBG_1206_3216Metric_ReverseMount_Hole2.2x2.2mm
LED64: =; LED__RBG_1206_3216Metric_ReverseMount_Hole2.2x2.2mm
LED65: BACKSPACE; LED__RBG_1206_3216Metric_ReverseMount_Hole2.2x2.2mm
LED66: INSERT; LED__RBG_1206_3216Metric_ReverseMount_Hole2.2x2.2mm
LED67: HOME; LED__RBG_1206_3216Metric_ReverseMount_Hole2.2x2.2mm
LED68: PG_UP; LED__RBG_1206_3216Metric_ReverseMount_Hole2.2x2.2mm
LED69: NUM_LK; LED__RBG_1206_3216Metric_ReverseMount_Hole2.2x2.2mm
LED70: PAD_/; LED__RBG_1206_3216Metric_ReverseMount_Hole2.2x2.2mm
LED71: *; LED__RBG_1206_3216Metric_ReverseMount_Hole2.2x2.2mm
LED72: PAD_-; LED__RBG_1206_3216Metric_ReverseMount_Hole2.2x2.2mm
LED73: P; LED__RBG_1206_3216Metric_ReverseMount_Hole2.2x2.2mm
LED74: [; LED__RBG_1206_3216Metric_ReverseMount_Hole2.2x2.2mm
LED75: }; LED__RBG_1206_3216Metric_ReverseMount_Hole2.2x2.2mm
LED76: \; LED__RBG_1206_3216Metric_ReverseMount_Hole2.2x2.2mm
LED77: DEL; LED__RBG_1206_3216Metric_ReverseMount_Hole2.2x2.2mm
LED78: END; LED__RBG_1206_3216Metric_ReverseMount_Hole2.2x2.2mm
LED79: PG_DN; LED__RBG_1206_3216Metric_ReverseMount_Hole2.2x2.2mm
LED80: PAD_7; LED__RBG_1206_3216Metric_ReverseMount_Hole2.2x2.2mm
LED81: PAD_8; LED__RBG_1206_3216Metric_ReverseMount_Hole2.2x2.2mm
LED82: PAD_9; LED__RBG_1206_3216Metric_ReverseMount_Hole2.2x2.2mm
LED83: +; LED__RBG_1206_3216Metric_ReverseMount_Hole2.2x2.2mm
LED84: ;; LED__RBG_1206_3216Metric_ReverseMount_Hole2.2x2.2mm
LED85: '; LED__RBG_1206_3216Metric_ReverseMount_Hole2.2x2.2mm
LED86: ENTER; LED__RBG_1206_3216Metric_ReverseMount_Hole2.2x2.2mm
LED87: PAD_4; LED__RBG_1206_3216Metric_ReverseMount_Hole2.2x2.2mm
LED88: PAD_5; LED__RBG_1206_3216Metric_ReverseMount_Hole2.2x2.2mm
LED89: PAD_6; LED__RBG_1206_3216Metric_ReverseMount_Hole2.2x2.2mm
LED90: .; LED__RBG_1206_3216Metric_ReverseMount_Hole2.2x2.2mm
LED91: /; LED__RBG_1206_3216Metric_ReverseMount_Hole2.2x2.2mm
LED92: R_SHIFT; LED__RBG_1206_3216Metric_ReverseMount_Hole2.2x2.2mm
LED93: UP_ARROW; LED__RBG_1206_3216Metric_ReverseMount_Hole2.2x2.2mm
LED94: PAD_1; LED__RBG_1206_3216Metric_ReverseMount_Hole2.2x2.2mm
LED95: PAD_2; LED__RBG_1206_3216Metric_ReverseMount_Hole2.2x2.2mm
LED96: PAD_3; LED__RBG_1206_3216Metric_ReverseMount_Hole2.2x2.2mm
LED97: R_ALT; LED__RBG_1206_3216Metric_ReverseMount_Hole2.2x2.2mm
LED98: FN; LED__RBG_1206_3216Metric_ReverseMount_Hole2.2x2.2mm
LED99: MENU; LED__RBG_1206_3216Metric_ReverseMount_Hole2.2x2.2mm
LED100: R_CTRL; LED__RBG_1206_3216Metric_ReverseMount_Hole2.2x2.2mm
LED101: L_ARROW; LED__RBG_1206_3216Metric_ReverseMount_Hole2.2x2.2mm
LED102: DN_ARROW; LED__RBG_1206_3216Metric_ReverseMount_Hole2.2x2.2mm
LED103: R_ARROW; LED__RBG_1206_3216Metric_ReverseMount_Hole2.2x2.2mm
LED104: PAD_0; LED__RBG_1206_3216Metric_ReverseMount_Hole2.2x2.2mm
LED105: PAD_.; LED__RBG_1206_3216Metric_ReverseMount_Hole2.2x2.2mm
LED106: PAD_ENTER; LED__RBG_1206_3216Metric_ReverseMount_Hole2.2x2.2mm
LED107, LED108, LED109, LED110, LED111, LED112, LED113, LED114, LED115, LED116, LED117, LED118, LED119: WS2812B; LED_WS2812B_PLCC4_5.0x5.0mm_P3.2mm
R3: 500; R_0805_2012Metric_Pad1.20x1.40mm_HandSolder
R_B1, R_B2, R_B3, R_B4, R_B5, R_B6, R_B7, R_B8, R_B9, R_B10, R_B11, R_B12, R_B13, R_B14, R_B15, R_B16, R_B17, R_B18, R_B19, R_B20: 20; R_0805_2012Metric_Pad1.20x1.40mm_HandSolder
R_G1, R_G2, R_G3, R_G4, R_G5, R_G6, R_G7, R_G8, R_G9, R_G10, R_G11, R_G12, R_G13, R_G14, R_G15, R_G16, R_G17, R_G18, R_G19, R_G20: 20; R_0805_2012Metric_Pad1.20x1.40mm_HandSolder
R_R1, R_R2, R_R3, R_R4, R_R5, R_R6, R_R7, R_R8, R_R9, R_R10, R_R11, R_R12, R_R13, R_R14, R_R15, R_R16, R_R17, R_R18, R_R19, R_R20: 51; R_0805_2012Metric_Pad1.20x1.40mm_HandSolder

Connections:
+5V: C18.1, C32.1, C34.1, C35.1, C36.1, C37.1, C38.1, C39.1, C40.1, C41.1, C42.1, C43.1, C44.1, LED107.1 (VDD), LED108.1 (VDD), LED109.1 (VDD), LED110.1 (VDD), LED111.1 (VDD), LED112.1 (VDD), LED113.1 (VDD), LED114.1 (VDD), LED115.1 (VDD), LED116.1 (VDD), LED117.1 (VDD), LED118.1 (VDD), LED119.1 (VDD)
CS1: R_B7.1
CS2: R_R7.1
CS3: R_G7.1
CS4: R_B8.1
CS5: R_R8.1
CS6: R_G8.1
CS7: R_B9.1
CS8: R_R9.1
CS9: R_G9.1
CS10: R_B10.1
CS11: R_R10.1
CS12: R_G10.1
CS13: R_B1.1
CS14: R_R1.1
CS15: R_G1.1
CS16: R_B2.1
CS17: R_R2.1
CS18: R_G2.1
CS19: R_B3.1
CS20: R_R3.1
CS21: R_G3.1
CS22: R_B4.1
CS23: R_R4.1
CS24: R_G4.1
CS25: R_B5.1
CS26: R_R5.1
CS27: R_G5.1
CS28: R_B6.1
CS29: R_R6.1
CS30: R_G6.1
CS31: R_B15.1
CS32: R_G15.1
CS33: R_R15.1
CS34: R_B16.1
CS35: R_G16.1
CS36: R_R16.1
CS37: R_B17.1
CS38: R_G17.1
CS39: R_R17.1
CS40: R_B18.1
CS41: R_R18.1
CS42: R_G18.1
CS43: R_B19.1
CS44: R_R19.1
CS45: R_G19.1
CS46: R_R20.1
CS47: R_G20.1
CS48: R_B20.1
CS49: R_B11.1
CS50: R_R11.1
CS51: R_G11.1
CS52: R_B12.1
CS53: R_R12.1
CS54: R_G12.1
CS55: R_B13.1
CS56: R_R13.1
CS57: R_G13.1
CS58: R_B14.1
CS59: R_R14.1
CS60: R_G14.1
GND: C18.2, C32.2, C34.2, C35.2, C36.2, C37.2, C38.2, C39.2, C40.2, C41.2, C42.2, C43.2, C44.2, LED107.3 (VSS), LED108.3 (VSS), LED109.3 (VSS), LED110.3 (VSS), LED111.3 (VSS), LED112.3 (VSS), LED113.3 (VSS), LED114.3 (VSS), LED115.3 (VSS), LED116.3 (VSS), LED117.3 (VSS), LED118.3 (VSS), LED119.3 (VSS)
unnamed: LED1.1 (RK), LED10.1 (RK), LED20.1 (RK), LED30.1 (RK), LED40.1 (RK), LED49.1 (RK), R_R1.2
unnamed: LED1.3 (GK), LED10.3 (GK), LED20.3 (GK), LED30.3 (GK), LED40.3 (GK), LED49.3 (GK), R_G1.2
unnamed: LED1.4 (BK), LED10.4 (BK), LED20.4 (BK), LED30.4 (BK), LED40.4 (BK), LED49.4 (BK), R_B1.2
unnamed: LED11.1 (RK), LED21.1 (RK), LED31.1 (RK), LED50.1 (RK), R_R2.2
unnamed: LED11.3 (GK), LED21.3 (GK), LED31.3 (GK), LED50.3 (GK), R_G2.2
unnamed: LED11.4 (BK), LED21.4 (BK), LED31.4 (BK), LED50.4 (BK), R_B2.2
unnamed: LED2.1 (RK), LED12.1 (RK), LED22.1 (RK), LED32.1 (RK), LED41.1 (RK), LED51.1 (RK), R_R3.2
unnamed: LED2.3 (GK), LED12.3 (GK), LED22.3 (GK), LED32.3 (GK), LED41.3 (GK), LED51.3 (GK), R_G3.2
unnamed: LED2.4 (BK), LED12.4 (BK), LED22.4 (BK), LED32.4 (BK), LED41.4 (BK), LED51.4 (BK), R_B3.2
unnamed: LED3.1 (RK), LED13.1 (RK), LED23.1 (RK), LED33.1 (RK), LED42.1 (RK), LED52.1 (RK), R_R4.2
unnamed: LED3.3 (GK), LED13.3 (GK), LED23.3 (GK), LED33.3 (GK), LED42.3 (GK), LED52.3 (GK), R_G4.2
unnamed: LED3.4 (BK), LED13.4 (BK), LED23.4 (BK), LED33.4 (BK), LED42.4 (BK), LED52.4 (BK), R_B4.2
unnamed: LED4.1 (RK), LED14.1 (RK), LED24.1 (RK), LED34.1 (RK), LED43.1 (RK), R_R5.2
unnamed: LED4.3 (GK), LED14.3 (GK), LED24.3 (GK), LED34.3 (GK), LED43.3 (GK), R_G5.2
unnamed: LED4.4 (BK), LED14.4 (BK), LED24.4 (BK), LED34.4 (BK), LED43.4 (BK), R_B5.2
unnamed: LED5.1 (RK), LED15.1 (RK), LED25.1 (RK), LED35.1 (RK), LED44.1 (RK), R_R6.2
unnamed: LED5.3 (GK), LED15.3 (GK), LED25.3 (GK), LED35.3 (GK), LED44.3 (GK), R_G6.2
unnamed: LED5.4 (BK), LED15.4 (BK), LED25.4 (BK), LED35.4 (BK), LED44.4 (BK), R_B6.2
unnamed: LED6.1 (RK), LED16.1 (RK), LED26.1 (RK), LED36.1 (RK), LED45.1 (RK), LED53.1 (RK), R_R7.2
unnamed: LED6.3 (GK), LED16.3 (GK), LED26.3 (GK), LED36.3 (GK), LED45.3 (GK), LED53.3 (GK), R_G7.2
unnamed: LED6.4 (BK), LED16.4 (BK), LED26.4 (BK), LED36.4 (BK), LED45.4 (BK), LED53.4 (BK), R_B7.2
unnamed: LED7.1 (RK), LED17.1 (RK), LED27.1 (RK), LED37.1 (RK), LED46.1 (RK), R_R8.2
unnamed: LED7.3 (GK), LED17.3 (GK), LED27.3 (GK), LED37.3 (GK), LED46.3 (GK), R_G8.2
unnamed: LED7.4 (BK), LED17.4 (BK), LED27.4 (BK), LED37.4 (BK), LED46.4 (BK), R_B8.2
unnamed: LED8.1 (RK), LED18.1 (RK), LED28.1 (RK), LED38.1 (RK), LED47.1 (RK), LED54.1 (RK), R_R9.2
unnamed: LED8.3 (GK), LED18.3 (GK), LED28.3 (GK), LED38.3 (GK), LED47.3 (GK), LED54.3 (GK), R_G9.2
unnamed: LED8.4 (BK), LED18.4 (BK), LED28.4 (BK), LED38.4 (BK), LED47.4 (BK), LED54.4 (BK), R_B9.2
unnamed: LED9.1 (RK), LED19.1 (RK), LED29.1 (RK), LED39.1 (RK), LED48.1 (RK), R_R10.2
unnamed: LED9.3 (GK), LED19.3 (GK), LED29.3 (GK), LED39.3 (GK), LED48.3 (GK), R_G10.2
unnamed: LED9.4 (BK), LED19.4 (BK), LED29.4 (BK), LED39.4 (BK), LED48.4 (BK), R_B10.2
unnamed: LED55.1 (RK), LED62.1 (RK), LED73.1 (RK), LED84.1 (RK), LED90.1 (RK), LED97.1 (RK), R_R11.2
unnamed: LED55.3 (GK), LED62.3 (GK), LED73.3 (GK), LED84.3 (GK), LED90.3 (GK), LED97.3 (GK), R_G11.2
unnamed: LED55.4 (BK), LED62.4 (BK), LED73.4 (BK), LED84.4 (BK), LED90.4 (BK), LED97.4 (BK), R_B11.2
unnamed: LED56.1 (RK), LED63.1 (RK), LED74.1 (RK), LED85.1 (RK), LED91.1 (RK), LED98.1 (RK), R_R12.2
unnamed: LED56.3 (GK), LED63.3 (GK), LED74.3 (GK), LED85.3 (GK), LED91.3 (GK), LED98.3 (GK), R_G12.2
unnamed: LED56.4 (BK), LED63.4 (BK), LED74.4 (BK), LED85.4 (BK), LED91.4 (BK), LED98.4 (BK), R_B12.2
unnamed: LED57.1 (RK), LED64.1 (RK), LED75.1 (RK), LED99.1 (RK), R_R13.2
unnamed: LED57.3 (GK), LED64.3 (GK), LED75.3 (GK), LED99.3 (GK), R_G13.2
unnamed: LED57.4 (BK), LED64.4 (BK), LED75.4 (BK), LED99.4 (BK), R_B13.2
unnamed: LED58.1 (RK), LED65.1 (RK), LED76.1 (RK), LED86.1 (RK), LED92.1 (RK), LED100.1 (RK), R_R14.2
unnamed: LED58.3 (GK), LED65.3 (GK), LED76.3 (GK), LED86.3 (GK), LED92.3 (GK), LED100.3 (GK), R_G14.2
unnamed: LED58.4 (BK), LED65.4 (BK), LED76.4 (BK), LED86.4 (BK), LED92.4 (BK), LED100.4 (BK), R_B14.2
unnamed: LED59.1 (RK), LED66.1 (RK), LED77.1 (RK), LED101.1 (RK), R_R15.2
unnamed: LED59.3 (GK), LED66.3 (GK), LED77.3 (GK), LED101.3 (GK), R_G15.2
unnamed: LED59.4 (BK), LED66.4 (BK), LED77.4 (BK), LED101.4 (BK), R_B15.2
unnamed: LED60.1 (RK), LED67.1 (RK), LED78.1 (RK), LED93.1 (RK), LED102.1 (RK), R_R16.2
unnamed: LED60.3 (GK), LED67.3 (GK), LED78.3 (GK), LED93.3 (GK), LED102.3 (GK), R_G16.2
unnamed: LED60.4 (BK), LED67.4 (BK), LED78.4 (BK), LED93.4 (BK), LED102.4 (BK), R_B16.2
unnamed: LED61.1 (RK), LED68.1 (RK), LED79.1 (RK), LED103.1 (RK), R_R17.2
unnamed: LED61.3 (GK), LED68.3 (GK), LED79.3 (GK), LED103.3 (GK), R_G17.2
unnamed: LED61.4 (BK), LED68.4 (BK), LED79.4 (BK), LED103.4 (BK), R_B17.2
unnamed: LED69.1 (RK), LED80.1 (RK), LED87.1 (RK), LED94.1 (RK), LED104.1 (RK), R_R18.2
unnamed: LED69.3 (GK), LED80.3 (GK), LED87.3 (GK), LED94.3 (GK), LED104.3 (GK), R_G18.2
unnamed: LED69.4 (BK), LED80.4 (BK), LED87.4 (BK), LED94.4 (BK), LED104.4 (BK), R_B18.2
unnamed: LED70.1 (RK), LED71.1 (RK), LED81.1 (RK), LED88.1 (RK), LED95.1 (RK), LED105.1 (RK), R_R19.2
unnamed: LED70.3 (GK), LED71.3 (GK), LED81.3 (GK), LED88.3 (GK), LED95.3 (GK), LED105.3 (GK), R_G19.2
unnamed: LED70.4 (BK), LED71.4 (BK), LED81.4 (BK), LED88.4 (BK), LED95.4 (BK), LED105.4 (BK), R_B19.2
unnamed: LED72.1 (RK), LED82.1 (RK), LED83.1 (RK), LED89.1 (RK), LED96.1 (RK), LED106.1 (RK), R_R20.2
unnamed: LED72.3 (GK), LED82.3 (GK), LED83.3 (GK), LED89.3 (GK), LED96.3 (GK), LED106.3 (GK), R_G20.2
unnamed: LED72.4 (BK), LED82.4 (BK), LED83.4 (BK), LED89.4 (BK), LED96.4 (BK), LED106.4 (BK), R_B20.2
unnamed: LED107.2 (DOUT), LED113.4 (DIN)
unnamed: LED107.4 (DIN), LED108.2 (DOUT)
unnamed: LED108.4 (DIN), LED109.2 (DOUT)
unnamed: LED109.4 (DIN), LED110.2 (DOUT)
unnamed: LED110.4 (DIN), LED111.2 (DOUT)
unnamed: LED111.4 (DIN), R3.2
unnamed: LED112.4 (DIN), LED114.2 (DOUT)
unnamed: LED113.2 (DOUT), LED115.4 (DIN)
unnamed: LED114.4 (DIN), LED117.2 (DOUT)
unnamed: LED115.2 (DOUT), LED118.4 (DIN)
unnamed: LED116.2 (DOUT), LED117.4 (DIN)
unnamed: LED116.4 (DIN), LED119.2 (DOUT)
unnamed: LED118.2 (DOUT), LED119.4 (DIN)
RGB_DI: R3.1
SW1: LED1.2 (A), LED2.2 (A), LED3.2 (A), LED4.2 (A), LED5.2 (A), LED6.2 (A), LED7.2 (A), LED8.2 (A), LED9.2 (A)
SW2: LED10.2 (A), LED11.2 (A), LED12.2 (A), LED13.2 (A), LED14.2 (A), LED15.2 (A), LED16.2 (A), LED17.2 (A), LED18.2 (A), LED19.2 (A)
SW3: LED20.2 (A), LED21.2 (A), LED22.2 (A), LED23.2 (A), LED24.2 (A), LED25.2 (A), LED26.2 (A), LED27.2 (A), LED28.2 (A), LED29.2 (A)
SW4: LED30.2 (A), LED31.2 (A), LED32.2 (A), LED33.2 (A), LED34.2 (A), LED35.2 (A), LED36.2 (A), LED37.2 (A), LED38.2 (A), LED39.2 (A)
SW5: LED40.2 (A), LED41.2 (A), LED42.2 (A), LED43.2 (A), LED44.2 (A), LED45.2 (A), LED46.2 (A), LED47.2 (A), LED48.2 (A)
SW6: LED49.2 (A), LED50.2 (A), LED51.2 (A), LED52.2 (A), LED53.2 (A), LED54.2 (A)
SW7: LED55.2 (A), LED56.2 (A), LED57.2 (A), LED58.2 (A), LED59.2 (A), LED60.2 (A), LED61.2 (A), LED71.2 (A), LED72.2 (A)
SW8: LED62.2 (A), LED63.2 (A), LED64.2 (A), LED65.2 (A), LED66.2 (A), LED67.2 (A), LED68.2 (A), LED69.2 (A), LED70.2 (A), LED83.2 (A)
SW9: LED73.2 (A), LED74.2 (A), LED75.2 (A), LED76.2 (A), LED77.2 (A), LED78.2 (A), LED79.2 (A), LED80.2 (A), LED81.2 (A), LED82.2 (A)
SW10: LED84.2 (A), LED85.2 (A), LED86.2 (A), LED87.2 (A), LED88.2 (A), LED89.2 (A)
SW11: LED90.2 (A), LED91.2 (A), LED92.2 (A), LED93.2 (A), LED94.2 (A), LED95.2 (A), LED96.2 (A)
SW12: LED97.2 (A), LED98.2 (A), LED99.2 (A), LED100.2 (A), LED101.2 (A), LED102.2 (A), LED103.2 (A), LED104.2 (A), LED105.2 (A), LED106.2 (A)

Notes on the sheet:
Right Side LEDs
Left Side LEDs
Underglow
