SteveT10/MX104-HS/(commit log)

2023-03-13 Setting up
    Created a new github repository and started new project in local folder. Located in documents/github.
    [KB-pcb-practice.kicad_pcb, KB-pcb-practice.kicad_sch]
2023-03-13 Added footprint libraries
    Opened Pcb file, added each lib's .pretty folder to project specific libraries.
2023-03-14 Day 1 work on schematic
    Added Decoupling capacitors and MCU to schematic.
    [KB-pcb-practice.kicad_sch]
2023-03-20 Added Clock Circuit to Sch
    [KB-pcb-practice.kicad_sch]
2023-03-20 Added reset circuit and Quad SPI Flash
    [KB-pcb-practice.kicad_sch]
2023-03-20 Mostly Finished Schematic
    Still looking for switches for reset and flash circuit.
    [KB-pcb-practice.kicad_sch, matrix.kicad_sch]
2023-03-30 Added SWD circuit, began RGB matrix
    [KB-pcb-practice.kicad_sch, rgbMatrix.kicad_sch]
2023-04-01 Started work on Led sch,
    Decided on led driver IC
    Decided on led part
    started work on led matrix
    [KB-pcb-practice.kicad_sch, rgbMatrix.kicad_sch]
2023-04-08 Changed led driver
    [KB-pcb-practice.kicad_sch, rgbMatrix.kicad_sch]
2023-04-12 Finished Electric Schematic Of Keyboard
    All components are now wired. Positions for spacers, button stabilizers, and threated holes not accounted.
    [KB-pcb-practice.kicad_sch, matrix.kicad_sch, rgbMatrix.kicad_sch]
2023-04-13 Started work on PCB layout
    Slightly Adjusted electric schematic as well.
    [KB-pcb-practice.kicad_pcb, KB-pcb-practice.kicad_sch, matrix.kicad_sch, rgbMatrix.kicad_sch]
2023-04-14 Changing hotswap switches
    Reverse Mount leds not added yet.
    [KB-pcb-practice.kicad_pcb, KB-pcb-practice.kicad_sch, matrix.kicad_sch, rgbMatrix.kicad_sch]
2023-04-14 Changed to reverse mount rgb leds
    Both symbol and footprint were changed accordingly.
    [KB-pcb-practice.kicad_pcb, KB-pcb-practice.kicad_sch, matrix.kicad_sch, rgbMatrix.kicad_sch]
2023-04-19 MCU pins all routed
    Just need to finish led drivers and connect matrix
    [KB-pcb-practice.kicadREV3_pcb.kicad_pcb, KB-pcb-practice.kicad_pcb, rgbMatrix.kicad_sch]
2023-04-19 Updated Schematic to match previous
    [KB-pcb-practice.kicad_sch, matrix.kicad_sch]
2023-04-24 Started Routing LED Drivers
    [KB-pcb-practice.kicad_pcb]
2023-04-25 Began Routing Columns and Rows
    [KB-pcb-practice.kicad_pcb, KB-pcb-practice.kicad_sch, matrix.kicad_sch, rgbMatrix.kicad_sch]
2023-04-25 Right LED Driver almost connected
    [KB-pcb-practice.kicadREV3_pcb.kicad_pcb, KB-pcb-practice.kicad_pcb, KB-pcb-practice.kicad_sch, matrix.kicad_sch, rgbMatrix.kicad_sch]
2023-04-26 Routing Finished
    [KB-pcb-practice.kicad_pcb, rgbMatrix.kicad_sch]
2023-05-04 Revising for underglow and PD IC
    [KB-pcb-practice.kicad_pcb, KB-pcb-practice.kicad_sch, matrix.kicad_sch]
2023-05-08 Rearranged LED Drivers
    [KB-pcb-practice.kicad_pcb, KB-pcb-practice.kicad_sch, matrix.kicad_sch, rgbMatrix.kicad_sch]
2023-05-09 Fixed Majority of Errors in ERC
    [KB-pcb-practice.kicad_pcb, KB-pcb-practice.kicad_sch, matrix.kicad_sch, rgbMatrix.kicad_sch]
2023-05-10 Added RGB Underglow
    [KB-pcb-practice.kicad_pcb, KB-pcb-practice.kicad_sch, matrix.kicad_sch, rgbMatrix.kicad_sch]
2023-05-11 Fixed Errors Relating to edge cuts
    [KB-pcb-practice.kicad_pcb, rgbMatrix.kicad_sch]
2023-06-14 Added fill zones and some art to PCB
    [KB-pcb-practice.kicad_sch]
2023-06-14 Added media folder and photos of Sch and PCB
2023-06-18 Reorganized Files
    [MX104-HS.kicad_sch, matrix.kicad_sch, rgbMatrix.kicad_sch]
2023-06-18 Updated submodules
    [MX104-HS.kicad_sch, matrix.kicad_sch, rgbMatrix.kicad_sch]
2023-07-02 Began changing out backlight for better components
    [MX104-HS.kicad_sch, rgbMatrix.kicad_sch]
2023-07-06 Finished version 1.0
    [MX104-HS.kicad_sch]
